Henry-Loi/Embedded-Game-Console/PCB/ELEC3300_V1.1_L4/ELEC3300_V1.1_L4/production/嘉立创SMT订单核对_ELEC3300_V1.1_L4_2023-11-17.pdf

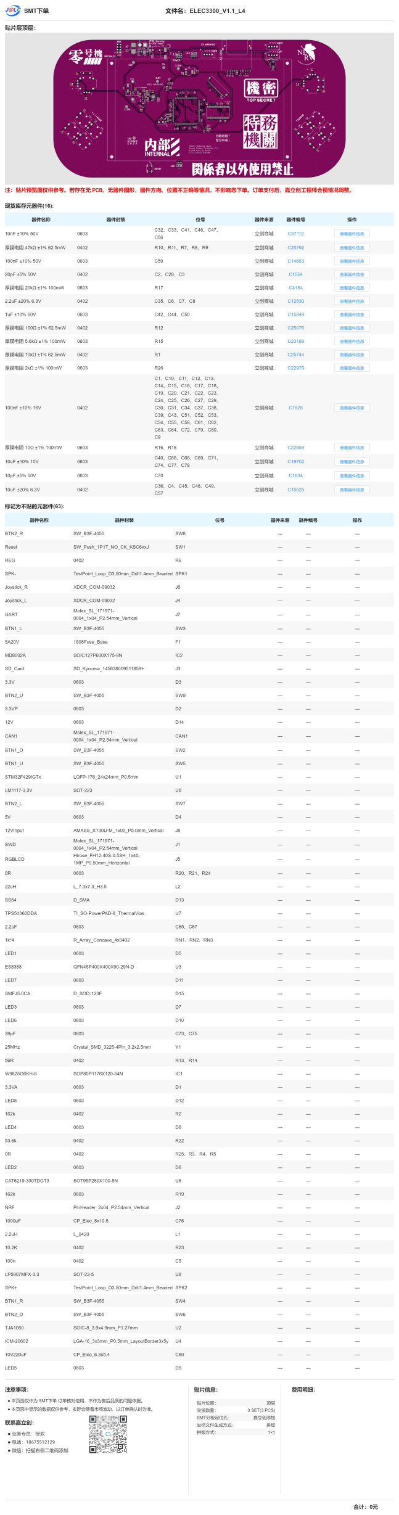
[picture p1: page 1]
