Henry-Loi/Embedded-Game-Console/PCB/screen.DXF

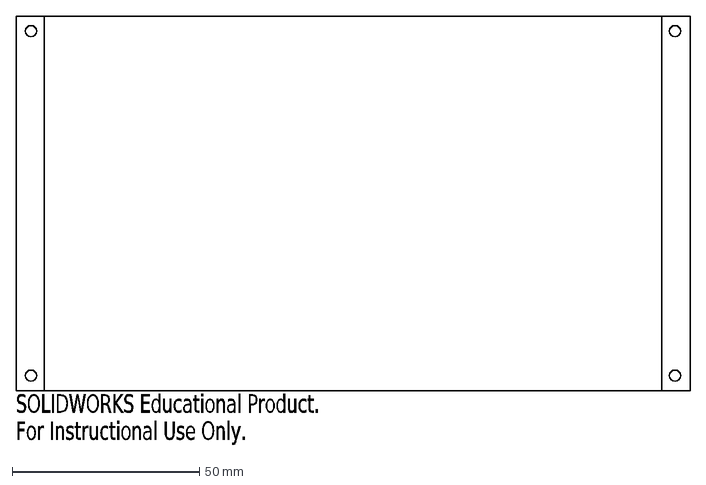
[picture p4: CAD file, 2023-11-17]
PCB/screen.DXF
SOLIDWORKS Educational Product.
For Instructional Use Only.
