Henry-Loi/Embedded-Game-Console/PCB/ELEC3300_V1.1_L4/ELEC3300_V1.1_L4/ELEC3300_V1.1_L4.pdf

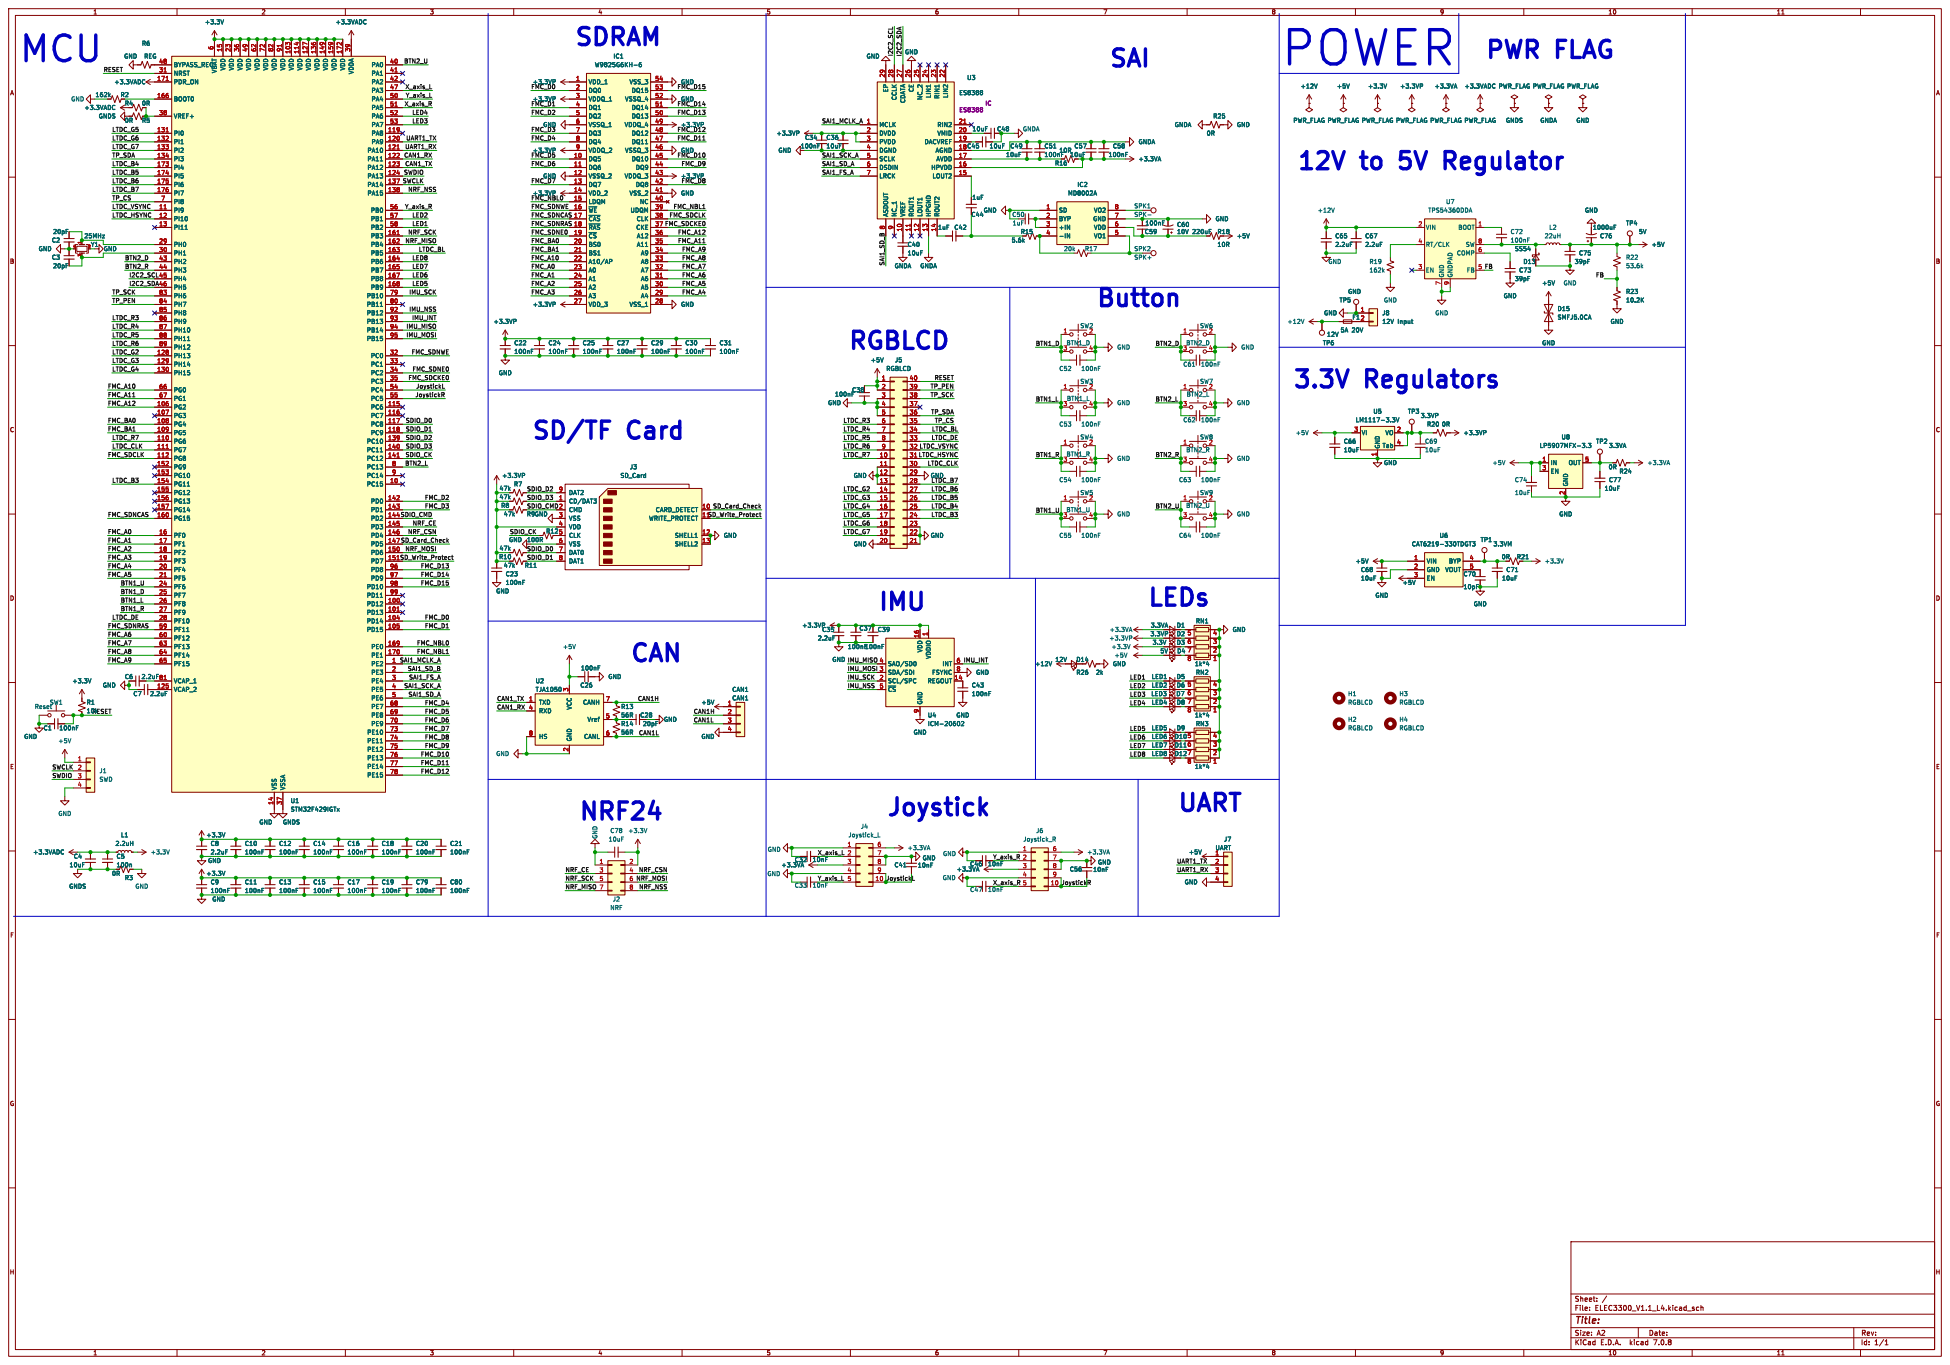
[picture p5: page 1]

1 REGOUT 14 VDD 16 SCL/SPC 2 SDA/SDI 3 SAO/SD0 4 ~{CS} 5

3 RXD 4 Vref 5 CANL 6 CANH 7 HS 8 U2 TJA1050 C19

3 RXD 4 Vref 5 CANL 6 CANH 7 HS 8 C21
