Henry-Loi/Embedded-Game-Console/PCB/ELEC3300_V1.1_L4/ELEC3300_V1.1_L4/ELEC3300_V1.1_L4.kicad_pcb

## KiCad design PCB/ELEC3300_V1.1_L4/ELEC3300_V1.1_L4/ELEC3300_V1.1_L4.kicad_pcb (2023-11-17)

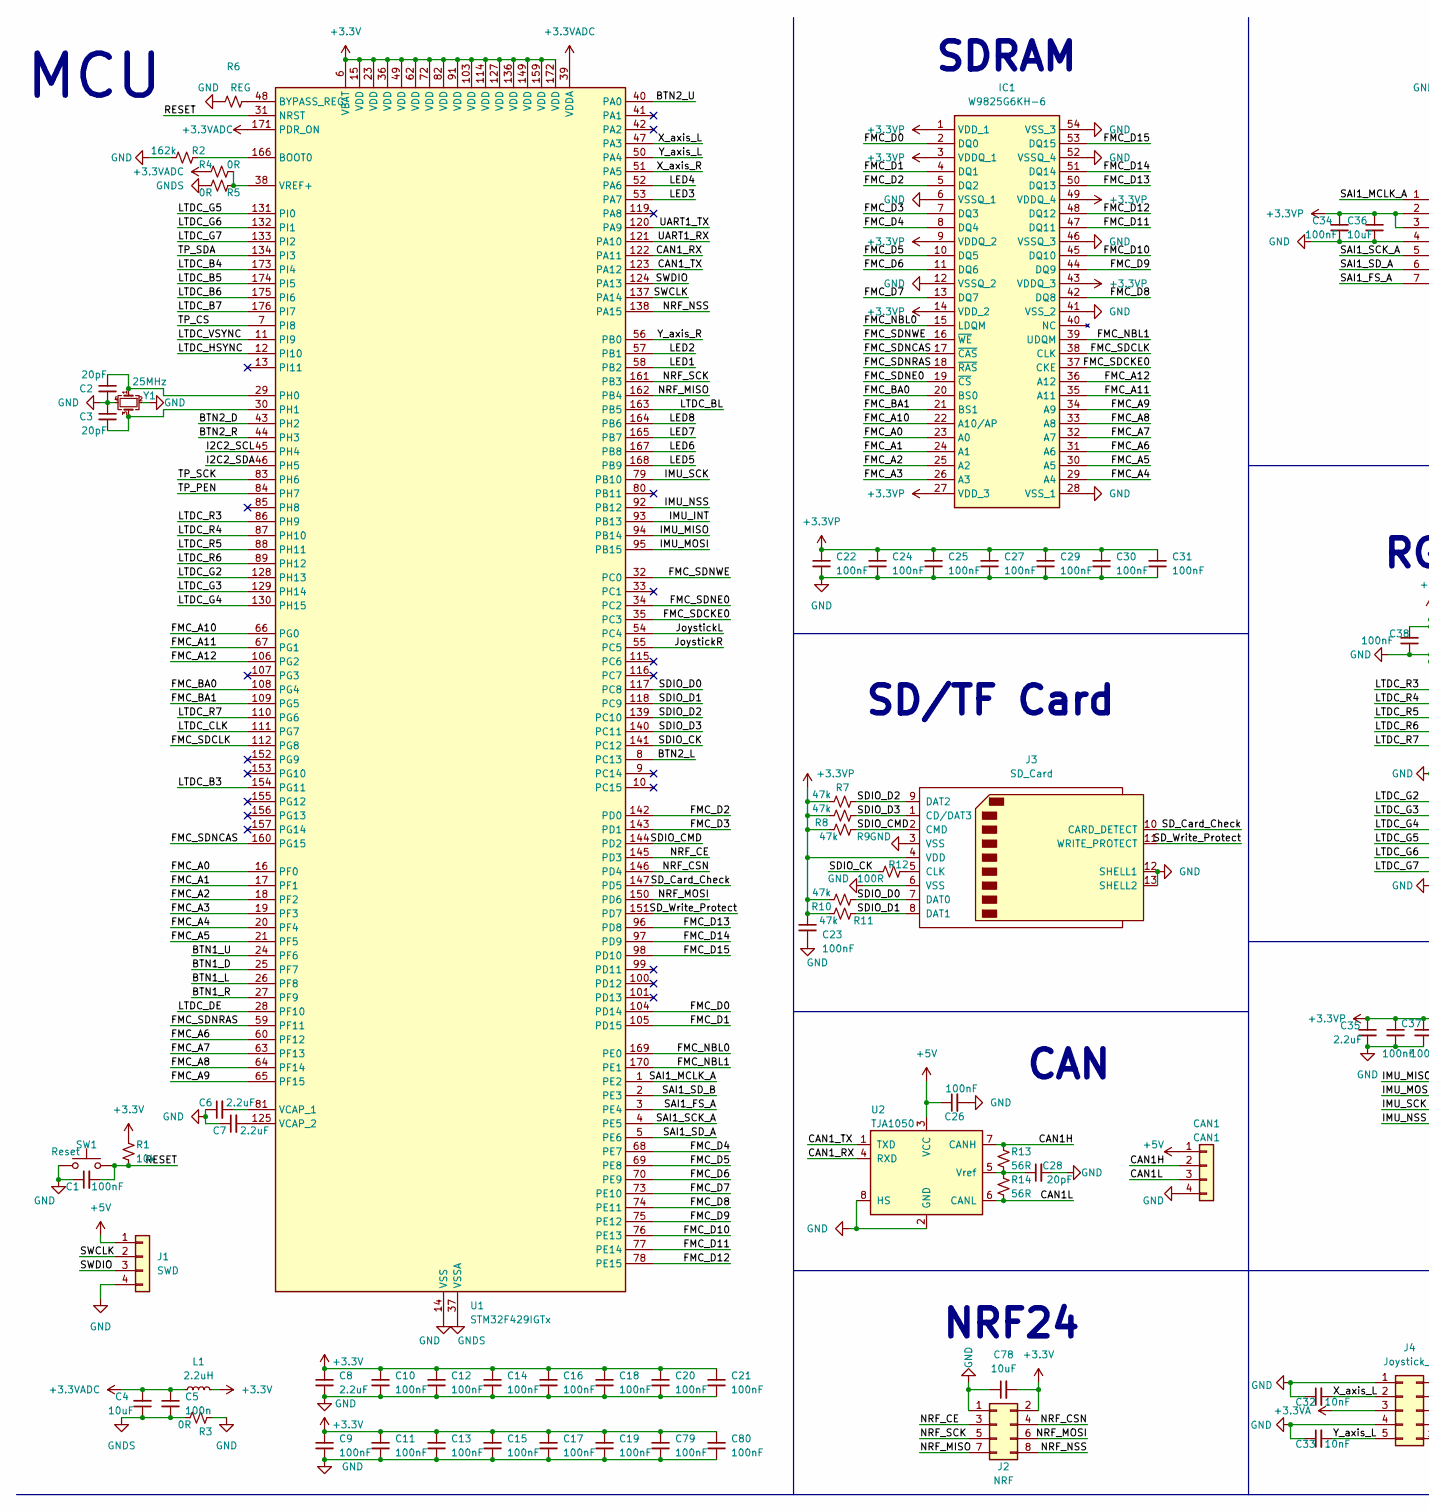
[picture p6: schematic ELEC3300_V1.1_L4.kicad_sch, part in row 1, column 1]

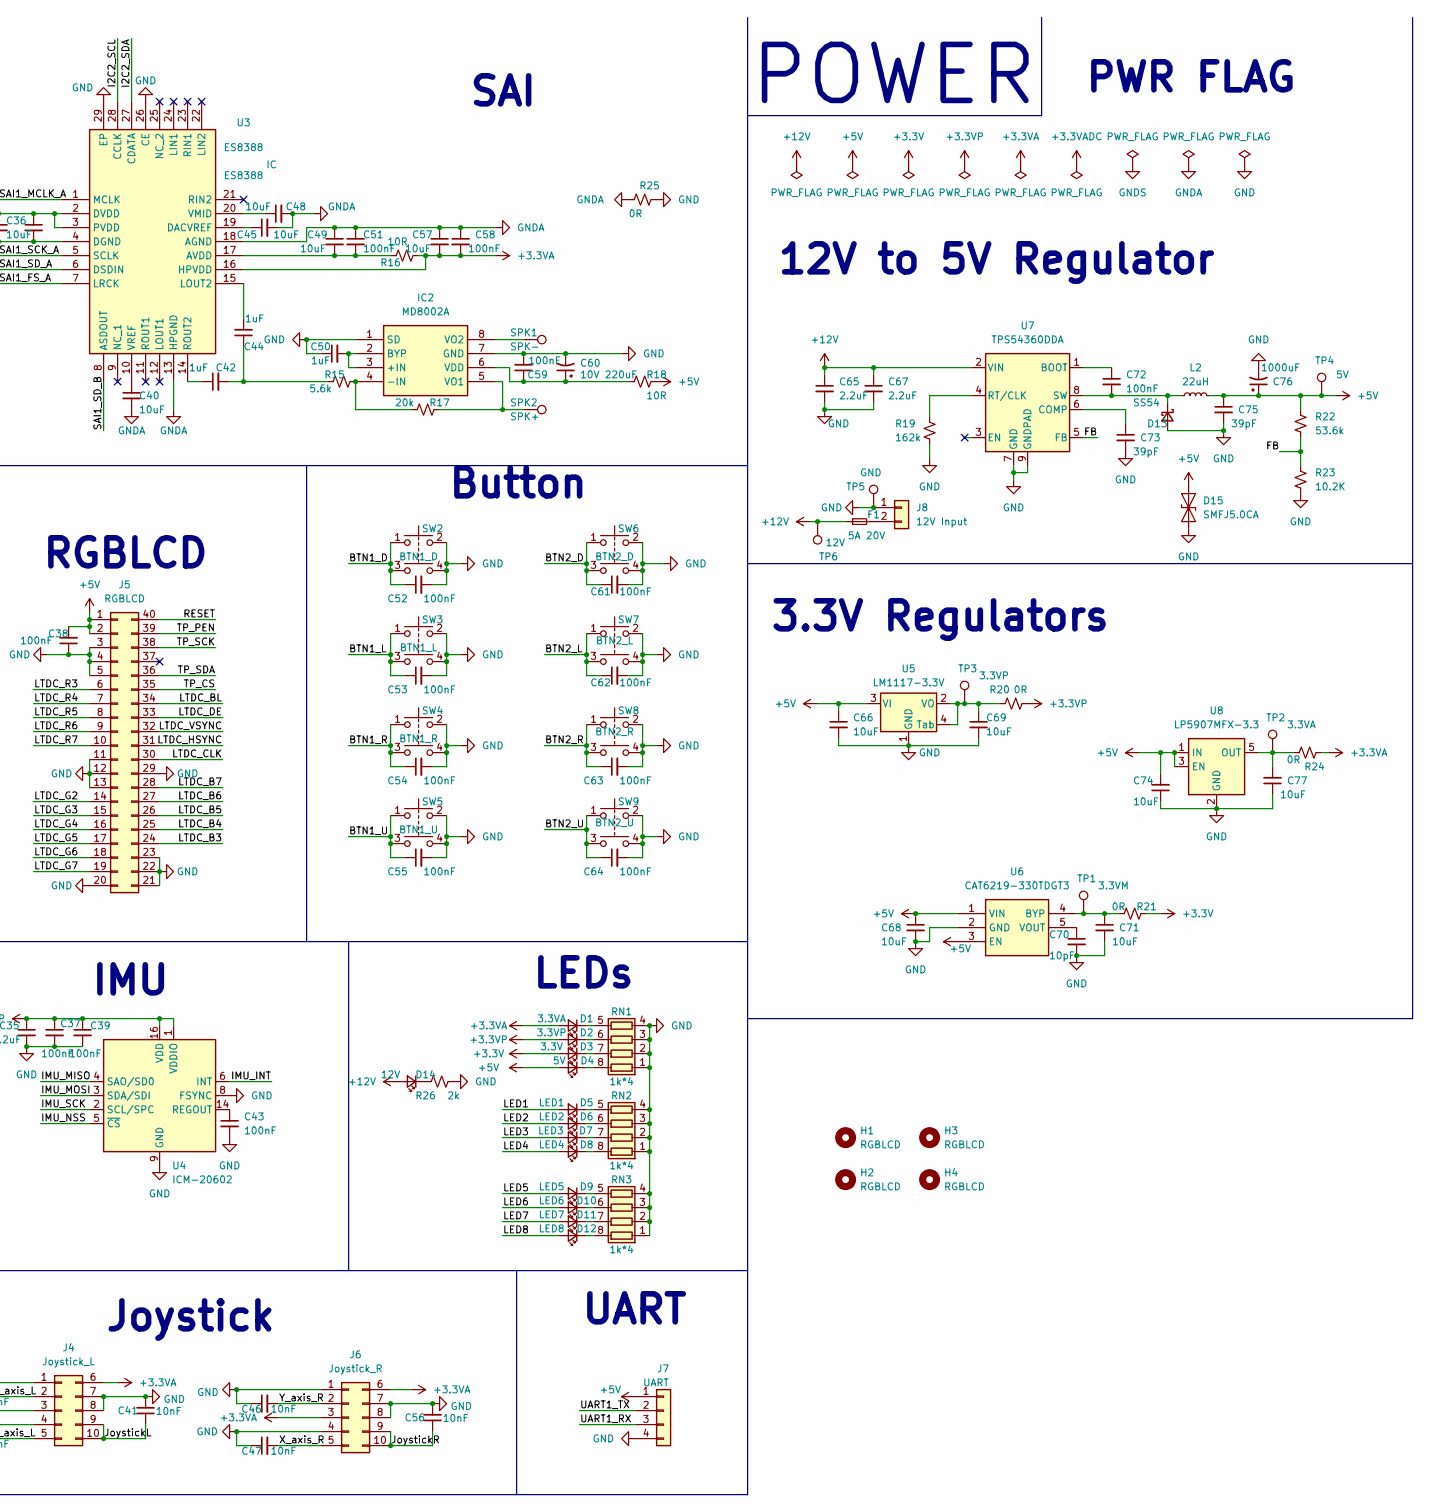
[picture p7: schematic ELEC3300_V1.1_L4.kicad_sch, part in row 1, column 2]

Parts:
C1, C9, C10, C11, C12, C13, C14, C15, C16, C17, C18, C19, C20, C21, C22, C23, C24, C25, C26, C27, C29, C30, C31, C34, C37, C38, C39, C43, C51, C52, C53, C54, C55, C58, C61, C62, C63, C64, C72, C79, C80: 100nF; C_0402_1005Metric_Pad0.74x0.62mm_HandSolder
C2, C3, C28: 20pF; C_0402_1005Metric_Pad0.74x0.62mm_HandSolder
C4, C36, C45, C49, C57: 10uF; C_0402_1005Metric_Pad0.74x0.62mm_HandSolder
C5: 100n; C_0402_1005Metric_Pad0.74x0.62mm_HandSolder
C6, C7, C8, C35: 2.2uF; C_0402_1005Metric_Pad0.74x0.62mm_HandSolder
C32, C33, C41, C46, C47, C56: 10nF; C_0603_1608Metric
C40, C66, C68, C69, C71, C74, C77, C78: 10uF; C_0603_1608Metric
C42, C44, C50: 1uF; C_0603_1608Metric
C48: 10uF; R_0402_1005Metric_Pad0.72x0.64mm_HandSolder
C59: 100nF; C_0603_1608Metric
C60: 10V 220uF; CP_Elec_6.3x5.4
C65, C67: 2.2uF; C_0603_1608Metric
C70: 10pF; C_0603_1608Metric
C73, C75: 39pF; C_0603_1608Metric
C76: 1000uF; CP_Elec_8x10.5
CAN1: CAN1; Molex_SL_171971-0004_1x04_P2.54mm_Vertical
D1: 3.3VA; LED_0603_1608Metric
D2: 3.3VP; LED_0603_1608Metric
D3: 3.3V; LED_0603_1608Metric
D4: 5V; LED_0603_1608Metric
D5: LED1; LED_0603_1608Metric
D6: LED2; LED_0603_1608Metric
D7: LED3; LED_0603_1608Metric
D8: LED4; LED_0603_1608Metric
D9: LED5; LED_0603_1608Metric
D10: LED6; LED_0603_1608Metric
D11: LED7; LED_0603_1608Metric
D12: LED8; LED_0603_1608Metric
D13: SS54; D_SMA
D14: 12V; LED_0603_1608Metric
D15: SMFJ5.0CA; D_SOD-123F
F1: 5A 20V; 1808Fuse_Base
H1, H2, H3, H4: RGBLCD; MountingHole_3.2mm_M3
IC1: W9825G6KH-6; SOP80P1176X120-54N; Manufacturer_Part_Number W9825G6KH-6; Mouser Part Number 454-W9825G6KH-6
IC2: MD8002A; SOIC127P600X175-8N; Manufacturer_Part_Number MD8002A
J1: SWD; Molex_SL_171971-0004_1x04_P2.54mm_Vertical
J2: NRF; PinHeader_2x04_P2.54mm_Vertical
J3: SD_Card; SD_Kyocera_145638009511859+
J4: Joystick_L; XDCR_COM-09032
J5: RGBLCD; Hirose_FH12-40S-0.5SH_1x40-1MP_P0.50mm_Horizontal
J6: Joystick_R; XDCR_COM-09032
J7: UART; Molex_SL_171971-0004_1x04_P2.54mm_Vertical
J8: 12V Input; AMASS_XT30U-M_1x02_P5.0mm_Vertical
L1: 2.2uH; L_0420
L2: 22uH; L_7.3x7.3_H3.5
R1: 10k; R_0402_1005Metric_Pad0.72x0.64mm_HandSolder
R2: 162k; L_0402_1005Metric_Pad0.77x0.64mm_HandSolder
R3, R4, R5, R25: 0R; R_0402_1005Metric_Pad0.72x0.64mm_HandSolder
R6: REG; R_0402_1005Metric_Pad0.72x0.64mm_HandSolder
R7, R8, R9, R10, R11: 47k; R_0402_1005Metric_Pad0.72x0.64mm_HandSolder
R12: 100R; R_0402_1005Metric_Pad0.72x0.64mm_HandSolder
R13, R14: 56R; R_0402_1005Metric_Pad0.72x0.64mm_HandSolder
R15: 5.6k; R_0603_1608Metric
R16, R18: 10R; R_0603_1608Metric
R17: 20k; R_0603_1608Metric
R19: 162k; R_0603_1608Metric
R20, R21, R24: 0R; R_0603_1608Metric_Pad0.98x0.95mm_HandSolder
R22: 53.6k; R_0402_1005Metric_Pad0.72x0.64mm_HandSolder
R23: 10.2K; R_0402_1005Metric_Pad0.72x0.64mm_HandSolder
R26: 2k; R_0603_1608Metric_Pad0.98x0.95mm_HandSolder
RN1, RN2, RN3: 1k*4; R_Array_Concave_4x0402
SPK1: SPK-; TestPoint_Loop_D3.50mm_Drill1.4mm_Beaded
SPK2: SPK+; TestPoint_Loop_D3.50mm_Drill1.4mm_Beaded
SW1: Reset; SW_Push_1P1T_NO_CK_KSC6xxJ
SW2: BTN1_D; SW_B3F-4055
SW3: BTN1_L; SW_B3F-4055
SW4: BTN1_R; SW_B3F-4055
SW5: BTN1_U; SW_B3F-4055
SW6: BTN2_D; SW_B3F-4055
SW7: BTN2_L; SW_B3F-4055
SW8: BTN2_R; SW_B3F-4055
SW9: BTN2_U; SW_B3F-4055
TP1: 3.3VM; TestPoint_Pad_D2.5mm
TP2: 3.3VA; TestPoint_Pad_D2.5mm
TP3: 3.3VP; TestPoint_Pad_D2.5mm
TP4: 5V; TestPoint_Pad_D2.5mm
TP5: GND; TestPoint_Pad_D2.5mm
TP6: 12V; TestPoint_Pad_D2.5mm
U1: STM32F429IGTx; LQFP-176_24x24mm_P0.5mm
U2: TJA1050; SOIC-8_3.9x4.9mm_P1.27mm
U3: ES8388; QFN45P400X400X90-29N-D; Manufacturer_Part_Number ES8388
U4: ICM-20602; LGA-16_3x3mm_P0.5mm_LayoutBorder3x5y
U5: LM1117-3.3V; SOT-223
U6: CAT6219-330TDGT3; SOT95P280X100-5N; Manufacturer_Part_Number CAT6219-330TDGT3; Mouser Part Number 698-CAT6219-330TD-G
U7: TPS54360DDA; TI_SO-PowerPAD-8_ThermalVias
U8: LP5907MFX-3.3; SOT-23-5
Y1: 25MHz; Crystal_SMD_3225-4Pin_3.2x2.5mm

Connections:
+3.3V: C8.1, C9.1, C10.1, C11.1, C12.1, C13.1, C14.1, C15.1, C16.1, C17.1, C18.1, C19.1, C20.1, C21.1, C78.2, C79.1, C80.1, D3.2 (A), J2.2, L1.2, R1.2, R21.2, U1.6 (VBAT), U1.15 (VDD), U1.23 (VDD), U1.36 (VDD), U1.49 (VDD), U1.62 (VDD), U1.72 (VDD), U1.82 (VDD), U1.91 (VDD), U1.103 (VDD), U1.114 (VDD), U1.127 (VDD), U1.136 (VDD), U1.149 (VDD), U1.159 (VDD), U1.172 (VDD)
+3.3VA: C57.2, C58.2, D1.2 (A), J4.3, J4.6, J6.3, J6.6, R16.2, R24.2, U3.16 (HPVDD)
+3.3VADC: C4.2, C5.1, L1.1, R4.1, U1.39 (VDDA), U1.171 (PDR_ON)
+3.3VP: C22.1, C23.1, C24.1, C25.1, C27.1, C29.1, C30.1, C31.1, C34.1, C35.1, C36.1, C37.1, C39.1, D2.2 (A), IC1.1 (VDD_1), IC1.3 (VDDQ_1), IC1.9 (VDDQ_2), IC1.14 (VDD_2), IC1.27 (VDD_3), IC1.43 (VDDQ_3), IC1.49 (VDDQ_4), J3.4 (VDD), R7.1, R8.1, R9.1, R10.1, R11.1, R20.2, U3.2 (DVDD), U3.3 (PVDD), U4.1 (VDDIO), U4.16 (VDD)
+5V: C26.1, C38.2, C66.1, C68.1, C74.2, C75.1, C76.1, CAN1.1, D4.2 (A), D15.1 (A1), J1.1, J5.1, J5.2, J7.1, L2.2, R18.2, R22.1, TP4.1, U2.3 (VCC), U5.3 (VI), U6.1 (VIN), U6.3 (EN), U8.1 (IN), U8.3 (EN)
+12V: C65.1, C67.1, D14.2 (A), F1.1, TP6.1, U7.2 (VIN)
/BTN1_D: C52.1, SW2.1, SW2.3, U1.25 (PF7)
/BTN1_L: C53.1, SW3.1, SW3.3, U1.26 (PF8)
/BTN1_R: C54.1, SW4.1, SW4.3, U1.27 (PF9)
/BTN1_U: C55.1, SW5.1, SW5.3, U1.24 (PF6)
/BTN2_D: C61.1, SW6.1, SW6.3, U1.43 (PH2)
/BTN2_L: C62.1, SW7.1, SW7.3, U1.8 (PC13)
/BTN2_R: C63.1, SW8.1, SW8.3, U1.44 (PH3)
/BTN2_U: C64.1, SW9.1, SW9.3, U1.40 (PA0)
/CAN1H: CAN1.2, R13.1, U2.7 (CANH)
/CAN1L: CAN1.3, R14.2, U2.6 (CANL)
/CAN1_RX: U1.122 (PA11), U2.4 (RXD)
/CAN1_TX: U1.123 (PA12), U2.1 (TXD)
/FB: R22.2, R23.1, U7.5 (FB)
/FMC_A0: IC1.23 (A0), U1.16 (PF0)
/FMC_A1: IC1.24 (A1), U1.17 (PF1)
/FMC_A2: IC1.25 (A2), U1.18 (PF2)
/FMC_A3: IC1.26 (A3), U1.19 (PF3)
/FMC_A4: IC1.29 (A4), U1.20 (PF4)
/FMC_A5: IC1.30 (A5), U1.21 (PF5)
/FMC_A6: IC1.31 (A6), U1.60 (PF12)
/FMC_A7: IC1.32 (A7), U1.63 (PF13)
/FMC_A8: IC1.33 (A8), U1.64 (PF14)
/FMC_A9: IC1.34 (A9), U1.65 (PF15)
/FMC_A10: IC1.22 (A10/AP), U1.66 (PG0)
/FMC_A11: IC1.35 (A11), U1.67 (PG1)
/FMC_A12: IC1.36 (A12), U1.106 (PG2)
/FMC_BA0: IC1.20 (BS0), U1.108 (PG4)
/FMC_BA1: IC1.21 (BS1), U1.109 (PG5)
/FMC_D0: IC1.2 (DQ0), U1.104 (PD14)
/FMC_D1: IC1.4 (DQ1), U1.105 (PD15)
/FMC_D2: IC1.5 (DQ2), U1.142 (PD0)
/FMC_D3: IC1.7 (DQ3), U1.143 (PD1)
/FMC_D4: IC1.8 (DQ4), U1.68 (PE7)
/FMC_D5: IC1.10 (DQ5), U1.69 (PE8)
/FMC_D6: IC1.11 (DQ6), U1.70 (PE9)
/FMC_D7: IC1.13 (DQ7), U1.73 (PE10)
/FMC_D8: IC1.42 (DQ8), U1.74 (PE11)
/FMC_D9: IC1.44 (DQ9), U1.75 (PE12)
/FMC_D10: IC1.45 (DQ10), U1.76 (PE13)
/FMC_D11: IC1.47 (DQ11), U1.77 (PE14)
/FMC_D12: IC1.48 (DQ12), U1.78 (PE15)
/FMC_D13: IC1.50 (DQ13), U1.96 (PD8)
/FMC_D14: IC1.51 (DQ14), U1.97 (PD9)
/FMC_D15: IC1.53 (DQ15), U1.98 (PD10)
/FMC_NBL0: IC1.15 (LDQM), U1.169 (PE0)
/FMC_NBL1: IC1.39 (UDQM), U1.170 (PE1)
/FMC_SDCKE0: IC1.37 (CKE), U1.35 (PC3)
/FMC_SDCLK: IC1.38 (CLK), U1.112 (PG8)
/FMC_SDNCAS: IC1.17 (~CAS), U1.160 (PG15)
/FMC_SDNE0: IC1.19 (~CS), U1.34 (PC2)
/FMC_SDNRAS: IC1.18 (~RAS), U1.59 (PF11)
/FMC_SDNWE: IC1.16 (~WE), U1.32 (PC0)
/I2C2_SCL: U1.45 (PH4), U3.28 (CCLK)
/I2C2_SDA: U1.46 (PH5), U3.27 (CDATA)
/IMU_INT: U1.93 (PB13), U4.6 (INT)
/IMU_MISO: U1.94 (PB14), U4.4 (SAO/SD0)
/IMU_MOSI: U1.95 (PB15), U4.3 (SDA/SDI)
/IMU_NSS: U1.92 (PB12), U4.5 (~CS)
/IMU_SCK: U1.79 (PB10), U4.2 (SCL/SPC)
/JoystickL: C41.1, J4.9, J4.10, U1.54 (PC4)
/JoystickR: C56.1, J6.9, J6.10, U1.55 (PC5)
/LED1: D5.2 (A), U1.58 (PB2)
/LED2: D6.2 (A), U1.57 (PB1)
/LED3: D7.2 (A), U1.53 (PA7)
/LED4: D8.2 (A), U1.52 (PA6)
/LED5: D9.2 (A), U1.168 (PB9)
/LED6: D10.2 (A), U1.167 (PB8)
/LED7: D11.2 (A), U1.165 (PB7)
/LED8: D12.2 (A), U1.164 (PB6)
/LTDC_B3: J5.24, U1.154 (PG11)
/LTDC_B4: J5.25, U1.173 (PI4)
/LTDC_B5: J5.26, U1.174 (PI5)
/LTDC_B6: J5.27, U1.175 (PI6)
/LTDC_B7: J5.28, U1.176 (PI7)
/LTDC_BL: J5.34, U1.163 (PB5)
/LTDC_CLK: J5.30, U1.111 (PG7)
/LTDC_DE: J5.33, U1.28 (PF10)
/LTDC_G2: J5.14, U1.128 (PH13)
/LTDC_G3: J5.15, U1.129 (PH14)
/LTDC_G4: J5.16, U1.130 (PH15)
/LTDC_G5: J5.17, U1.131 (PI0)
/LTDC_G6: J5.18, U1.132 (PI1)
/LTDC_G7: J5.19, U1.133 (PI2)
/LTDC_HSYNC: J5.31, U1.12 (PI10)
/LTDC_R3: J5.6, U1.86 (PH9)
/LTDC_R4: J5.7, U1.87 (PH10)
/LTDC_R5: J5.8, U1.88 (PH11)
/LTDC_R6: J5.9, U1.89 (PH12)
/LTDC_R7: J5.10, U1.110 (PG6)
/LTDC_VSYNC: J5.32, U1.11 (PI9)
/NRF_CE: J2.3, U1.145 (PD3)
/NRF_CSN: J2.4, U1.146 (PD4)
/NRF_MISO: J2.7, U1.162 (PB4)
/NRF_MOSI: J2.6, U1.150 (PD6)
/NRF_NSS: J2.8, U1.138 (PA15)
/NRF_SCK: J2.5, U1.161 (PB3)
/RESET: C1.2, J5.40, R1.1, SW1.2, U1.31 (NRST)
/SAI1_FS_A: U1.3 (PE4), U3.7 (LRCK)
/SAI1_MCLK_A: U1.1 (PE2), U3.1 (MCLK)
/SAI1_SCK_A: U1.4 (PE5), U3.5 (SCLK)
/SAI1_SD_A: U1.5 (PE6), U3.6 (DSDIN)
/SAI1_SD_B: U1.2 (PE3), U3.8 (ASDOUT)
/SDIO_CK: R12.1, U1.141 (PC12)
/SDIO_CMD: J3.2 (CMD), R9.2, U1.144 (PD2)
/SDIO_D0: J3.7 (DAT0), R10.2, U1.117 (PC8)
/SDIO_D1: J3.8 (DAT1), R11.2, U1.118 (PC9)
/SDIO_D2: J3.9 (DAT2), R7.2, U1.139 (PC10)
/SDIO_D3: J3.1 (CD/DAT3), R8.2, U1.140 (PC11)
/SD_Card_Check: J3.10 (CARD_DETECT), U1.147 (PD5)
/SD_Write_Protect: J3.11 (WRITE_PROTECT), U1.151 (PD7)
/SWCLK: J1.2, U1.137 (PA14)
/SWDIO: J1.3, U1.124 (PA13)
/TP_CS: J5.35, U1.7 (PI8)
/TP_PEN: J5.39, U1.84 (PH7)
/TP_SCK: J5.38, U1.83 (PH6)
/TP_SDA: J5.36, U1.134 (PI3)
/UART1_RX: J7.3, U1.121 (PA10)
/UART1_TX: J7.2, U1.120 (PA9)
/X_axis_L: C32.2, J4.2, U1.47 (PA3)
/X_axis_R: C47.2, J6.5, U1.51 (PA5)
/Y_axis_L: C33.2, J4.5, U1.50 (PA4)
/Y_axis_R: C46.2, J6.2, U1.56 (PB0)
GND: C1.1, C2.2, C3.1, C6.1, C7.1, C8.2, C9.2, C10.2, C11.2, C12.2, C13.2, C14.2, C15.2, C16.2, C17.2, C18.2, C19.2, C20.2, C21.2, C22.2, C23.2, C24.2, C25.2, C26.2, C27.2, C28.2, C29.2, C30.2, C31.2, C32.1, C33.1, C34.2, C35.2, C36.2, C37.2, C38.1, C39.2, C41.2, C43.2, C46.1, C47.1, C50.1, C52.2, C53.2, C54.2, C55.2, C56.2, C59.2, C60.2, C61.2, C62.2, C63.2, C64.2, C65.2, C66.2, C67.2, C68.2, C69.2, C70.2, C71.2, C73.2, C74.1, C75.2, C76.2, C77.1, C78.1, C79.2, C80.2, CAN1.4, D13.2 (A), D15.2 (A2), IC1.6 (VSSQ_1), IC1.12 (VSSQ_2), IC1.28 (VSS_1), IC1.41 (VSS_2), IC1.46 (VSSQ_3), IC1.52 (VSSQ_4), IC1.54 (VSS_3), IC2.1 (SD), IC2.7 (GND), J1.4, J2.1, J3.3 (VSS), J3.6 (VSS), J3.12 (SHELL1), J3.13 (SHELL2), J4.1, J4.4, J4.7, J4.8, J5.3, J5.4, J5.5, J5.11, J5.12, J5.13, J5.20, J5.21, J5.22, J5.23, J5.29, J6.1, J6.4, J6.7, J6.8, J7.4, J8.1, R2.1, R3.2, R6.1, R19.2, R23.2, R25.2, R26.2, RN1.1 (R1.1), RN1.2 (R2.1), RN1.3 (R3.1), RN1.4 (R4.1), RN2.1 (R1.1), RN2.2 (R2.1), RN2.3 (R3.1), RN2.4 (R4.1), RN3.1 (R1.1), RN3.2 (R2.1), RN3.3 (R3.1), RN3.4 (R4.1), SW1.1, SW2.2, SW2.4, SW3.2, SW3.4, SW4.2, SW4.4, SW5.2, SW5.4, SW6.2, SW6.4, SW7.2, SW7.4, SW8.2, SW8.4, SW9.2, SW9.4, TP5.1, U1.14 (VSS), U1.22 (VSS), U1.61 (VSS), U1.71 (VSS), U1.90 (VSS), U1.102 (VSS), U1.113 (VSS), U1.126 (VSS), U1.135 (VSS), U1.148 (VSS), U1.158 (VSS), U2.2 (GND), U2.8 (HS), U3.4 (DGND), U3.26 (CE), U3.29 (EP), U4.8 (FSYNC), U4.9 (GND), U4.10 (GND), U4.11 (GND), U4.12 (GND), U4.13 (GND), U4.15 (GND), U5.1 (GND), U6.2 (GND), U7.7 (GND), U7.9 (GNDPAD), U8.2 (GND), Y1.2, Y1.4
GNDA: C40.2, C45.2, C48.2, C49.1, C51.1, C57.1, C58.1, R25.1, U3.13 (HPGND), U3.18 (AGND)
GNDS: C4.1, C5.2, R3.1, R5.1, U1.37 (VSSA)
unnamed: C42.2, C44.1, R15.1
unnamed: D1.1 (K), RN1.5 (R4.2)
unnamed: D2.1 (K), RN1.6 (R3.2)
unnamed: D3.1 (K), RN1.7 (R2.2)
unnamed: D4.1 (K), RN1.8 (R1.2)
unnamed: D5.1 (K), RN2.5 (R4.2)
unnamed: D6.1 (K), RN2.6 (R3.2)
unnamed: D7.1 (K), RN2.7 (R2.2)
unnamed: D8.1 (K), RN2.8 (R1.2)
unnamed: D9.1 (K), RN3.5 (R4.2)
unnamed: D10.1 (K), RN3.6 (R3.2)
unnamed: D11.1 (K), RN3.7 (R2.2)
unnamed: D12.1 (K), RN3.8 (R1.2)
unnamed: C72.2, D13.1 (K), L2.1, U7.8 (SW)
unnamed: D14.1 (K), R26.1
unnamed: C50.2, IC2.2 (BYP), IC2.3 (+IN)
unnamed: IC2.4 (-IN), R15.2, R17.1
unnamed: C59.1, C60.1, IC2.6 (VDD), R18.1
unnamed: IC2.5 (VO1), R17.2, SPK2.1
unnamed: IC2.8 (VO2), SPK1.1
unnamed: J3.5 (CLK), R12.2
unnamed: F1.2, J8.2
unnamed: R2.2, U1.166 (BOOT0)
unnamed: R6.2, U1.48 (BYPASS_REG)
unnamed: C2.1, U1.29 (PH0), Y1.1
unnamed: C3.2, U1.30 (PH1), Y1.3
unnamed: C6.2, U1.81 (VCAP_1)
unnamed: C7.2, U1.125 (VCAP_2)
unnamed: R4.2, R5.2, U1.38 (VREF+)
unnamed: C28.1, R13.2, R14.1, U2.5 (Vref)
unnamed: C49.2, C51.2, R16.1, U3.17 (AVDD)
unnamed: C45.1, U3.19 (DACVREF)
unnamed: C44.2, U3.15 (LOUT2)
unnamed: C42.1, U3.14 (ROUT2)
unnamed: C48.1, U3.20 (VMID)
unnamed: C40.1, U3.10 (VREF)
unnamed: C43.1, U4.14 (REGOUT)
unnamed: C69.1, R20.1, TP3.1, U5.2 (VO), U5.4 (Tab)
unnamed: C71.1, R21.1, TP1.1, U6.4 (BYP)
unnamed: C70.1, U6.5 (VOUT)
unnamed: C72.1, U7.1 (BOOT)
unnamed: C73.1, U7.6 (COMP)
unnamed: R19.1, U7.4 (RT/CLK)
unnamed: C77.2, R24.1, TP2.1, U8.5 (OUT)

Notes on the sheet:
3.3V Regulators
MCU
POWER
IMU
LEDs
Joystick
SAI
UART
PWR FLAG
12V to 5V Regulator
CAN
Button
RGBLCD
SD/TF Card
NRF24
SDRAM

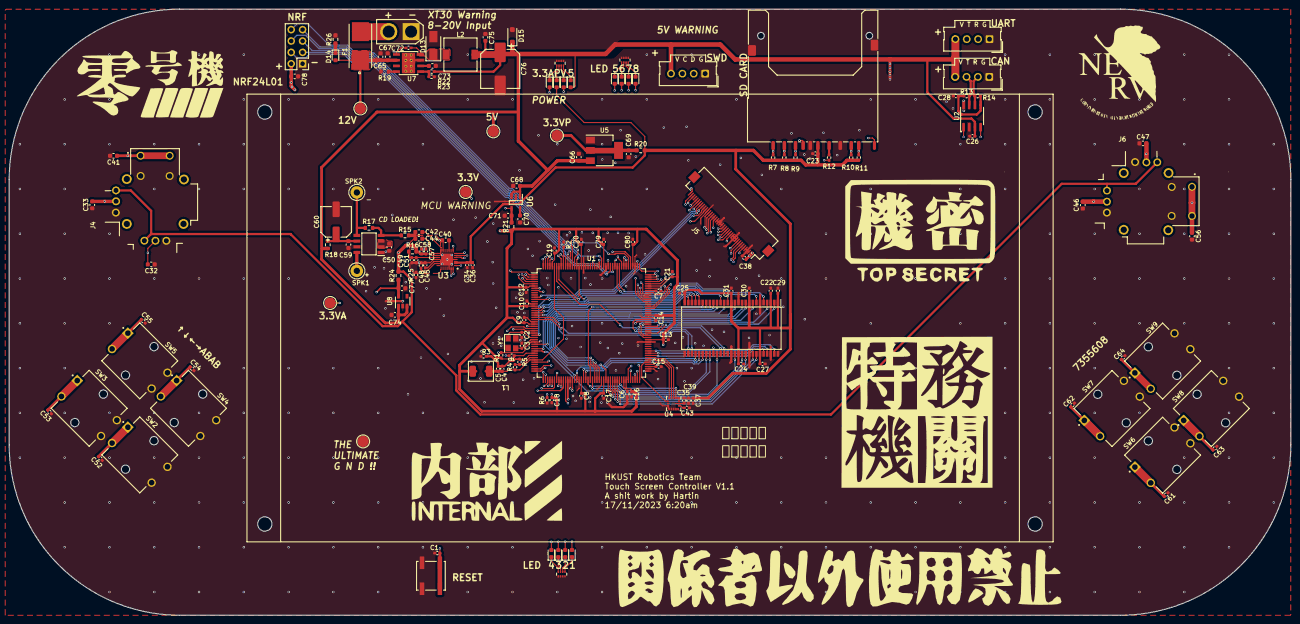
[picture p8: board ELEC3300_V1.1_L4.kicad_pcb from above]

Board: 4 copper layers, 286.2 x 135.3 mm, 168 parts (0 on the bottom side), 175 nets.
