Henry-Loi/Embedded-Game-Console/_My_RGB/Src/main.c

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

/* Includes ------------------------------------------------------------------*/
#include "main.h"
#include "dma.h"
#include "dma2d.h"
#include "fatfs.h"
#include "ltdc.h"
#include "sdio.h"
#include "usart.h"
#include "gpio.h"
#include "fmc.h"

/* USER CODE BEGIN Includes */

#include "BSP_RGB_LCD.h"
#include "image.h"
#include "GUI_Paint.h"
#include "GT911.h"
#include "malloc.h"	  
#include "usmart.h"
#include "ff.h"
#include "ff_gen_drv.h"	
#include "piclib.h"

/* USER CODE END Includes */

/* USER CODE BEGIN PTD */
extern GT911_Dev Dev_Now;

void HAL_GPIO_EXTI_Callback(uint16_t GPIO_Pin)
{
	if(GPIO_Pin == GPIO_PIN_7)
	{
		Dev_Now.Touch = 1;
	}
}
/* USER CODE END PTD */


void SystemClock_Config(void);
/* USER CODE BEGIN 0 */

//FATFS SDFatFs;  /* File system object for SD card logical drive */
//FIL MyFile;     /* File object */
//char SDPath[4]; /* SD card logical drive path */
//static uint8_t buffer[_MAX_SS]; /* a work buffer for the f_mkfs() */

uint16_t *picture = NULL;

/* USER CODE END 0 */

/**
  * @brief  The application entry point.
  * @retval int
  */
int main(void)
{
  /* USER CODE BEGIN 1 */
	
//  FRESULT res;                                          /* FatFs function common result code */
//  uint32_t byteswritten, bytesread;                     /* File write/read counts */
//  uint8_t wtext[] = "This is STM32 working with FatFs"; /* File write buffer */
//  uint8_t rtext[100];                                   /* File read buffer */
//	uint8_t buffer[512];
	
	
  /* USER CODE END 1 */
  

  /* MCU Configuration--------------------------------------------------------*/

  /* Reset of all peripherals, Initializes the Flash interface and the Systick. */
  HAL_Init();

  /* Configure the system clock */
  SystemClock_Config();

  /* Initialize all configured peripherals */
  MX_GPIO_Init();
  MX_LTDC_Init();
  MX_FMC_Init();
  MX_DMA2D_Init();
  MX_USART1_UART_Init();
  MX_DMA_Init();
  MX_SDIO_SD_Init();
//  MX_FATFS_Init();
  /* USER CODE BEGIN 2 */
	
	/*LCD初始化*/
	BSP_LCD_Init();
	
	/*打开背光*/
	HAL_GPIO_WritePin(GPIOB,GPIO_PIN_5,GPIO_PIN_SET);
	
/*malloc.c中初始化内存池*/
	my_mem_init(SRAMIN);		    //初始化内部内存池
	my_mem_init(SRAMEX);		    //初始化外部内存池
	my_mem_init(SRAMCCM);		    //初始化CCM内存池 
	
/*USMART调试工具初始化*/
	usmart_dev.init(90);
	

	/*使能串口1接受中断*/
	__HAL_UART_ENABLE_IT(&huart1,UART_IT_RXNE); 
	
	/*为fatfs相关变量申请内存	*/
	exfuns_init();
	
	/*FATFS文件系统初始化，初始化SD卡并挂载SD卡*/
	if(FATFS_LinkDriver(&SD_Driver, SDPath) == 0)
		{
			/*##-2- Register the file system object to the FatFs module ##############*/
			if(f_mount(&SDFatFS, (TCHAR const*)SDPath, 0) != FR_OK)
			{
				/* FatFs Initialization Error */
				Error_Handler();
				Debug("挂载失败\r\n");
			}
			else
			{
				/*##-3- Create a FAT file system (format) on the logical drive #########*/
				/* WARNING: Formatting the uSD card will delete all content on the device */
				if(disk_initialize(0) != 0)//在这一步进行了SD卡初始化   f_mkfs((TCHAR const*)SDPath, FM_ANY, 0, buffer, sizeof(buffer)) != FR_OK  disk_initialize(0) != 0
				{
					/* FatFs Format Error */
					Error_Handler();
					Debug("SD卡初始化失败\r\n");
				}
				else
				{       
					/*##-4- Create and Open a new text file object with write access #####*/
//					if(f_open(&SDFile, "STM32.TXT", FA_CREATE_ALWAYS | FA_WRITE) != FR_OK)
//					{
//						/* 'STM32.TXT' file Open for write Error */
//						Error_Handler();
//						Debug("创建文件失败\r\n");
//					}
//					else
//					{
//						/*##-5- Write data to the text file ################################*/
//						res = f_write(&SDFile, wtext, sizeof(wtext), (void *)&byteswritten);

//						/*##-6- Close the open text file #################################*/
//						if (f_close(&SDFile) != FR_OK )
//						{
//							Error_Handler();
//							Debug("关闭文件失败\r\n");
//						}
//						
//						if((byteswritten == 0) || (res != FR_OK))
//						{
//							/* 'STM32.TXT' file Write or EOF Error */
//							Error_Handler();
//							Debug("写文件信息失败\r\n");
//						}
//						else
//						{      
//							/*##-7- Open the text file object with read access ###############*/
//							if(f_open(&SDFile, "STM32.TXT", FA_READ) != FR_OK)
//							{
//								/* 'STM32.TXT' file Open for read Error */
//								Error_Handler();
//								Debug("文件打开失败\r\n");
//							}
//							else
//							{
//								/*##-8- Read data from the text file ###########################*/
//								res = f_read(&SDFile, rtext, sizeof(rtext), (UINT*)&bytesread);
//								
//								if((bytesread == 0) || (res != FR_OK))
//								{
//									/* 'STM32.TXT' file Read or EOF Error */
//									Error_Handler();
//									Debug("文件读取失败或EOF错误\r\n");
//								}
//								else
//								{
//									/*##-9- Close the open text file #############################*/
//									f_close(&SDFile);
//									
//									/*##-10- Compare read data with the expected data ############*/
//									if((bytesread != byteswritten))
//									{                
//										/* Read data is different from the expected data */
//										Error_Handler();
//										Debug("读数据不同\r\n");
//									}
//									else
//									{
										/* Success of the demo: no error occurrence */
										Debug("SD卡挂载并写入成功\r\n");
//									}
//								}
//							}
//						}
//					}
				}
			}
		}
		else
		{
			/* Read data is different from the expected data */
			Error_Handler();
			Debug("FATFS文件系统链接失败r\n");		
		}
		
		
	/*刷屏代码*/
	Paint_NewImage(LCD_WIDTH, LCD_HEIGHT, ROTATE_0, WHITE);
	Paint_Clear(WHITE);
	Paint_DrawString_EN(10, 230, "1234567890", &Font24, 0x000f, 0xfff0);
	Paint_DrawString_EN(10, 260, "ABCDEFGHIJ", &Font24, BLUE, CYAN);
	Paint_DrawString_CN(10, 290, "微雪电子", &Font24CN, BLUE, CYAN);

	Paint_DrawRectangle(200, 230, 300, 330, RED,DRAW_FILL_EMPTY, DOT_PIXEL_2X2 );
	Paint_DrawLine(200, 230, 300, 330, MAGENTA, LINE_STYLE_SOLID, DOT_PIXEL_2X2);
	Paint_DrawLine(300, 230, 200, 330, MAGENTA, LINE_STYLE_SOLID, DOT_PIXEL_2X2);
	Paint_DrawCircle(250, 280, 45, GREEN, DRAW_FILL_EMPTY, DOT_PIXEL_2X2);
	Paint_DrawImage(gImage_800X221, 0, 0, 800, 221);
	Paint_DrawString_EN(715, 0, "clear", &Font24, BLUE, CYAN);/*每个字符占17个x坐标 24个Y坐标*/
	
	/*GT9147触摸IC初始化*/
	GT911_Init();
		
	/*解码图片*/	
//	if(f_open(&SDFile, "image.jpg", FA_READ) == FR_OK)
//	{
//		/* Decode the jpg image file */
//		Debug("文件打开成功\r\n");
//		jpeg_decode(&SDFile, 800, _aucLine, Jpeg_CallbackFunction);
		picture = (uint16_t*)mymalloc(SRAMEX,800*480*2);
		piclib_init();										//初始化画图	
		ai_load_picfile((const u8*)"0:/image2.jpg",0,0,800,480,1);//显示图片   
		
//		Paint_DrawImage((const unsigned char*)picture, 0, 0, 800, 480);
		
		myfree(SRAMEX,picture);
		/* Close the JPG image */
//		f_close(&SDFile);
//	}	
//	else
//	{
//		Debug("文件打开失败\r\n");
//	}
  /* USER CODE END 2 */

  /* Infinite loop */
  /* USER CODE BEGIN WHILE */
  while (1)
  {

        		
		ctp_test();
    /* USER CODE END WHILE */

    /* USER CODE BEGIN 3 */
  }
  /* USER CODE END 3 */
}

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
