Henry-Loi/Embedded-Game-Console/ELEC3300/ELEC3300.ioc

Mcu.UserName=STM32F429IGTx
PA0/WKUP.GPIO_Label=BTN2_U
PA0/WKUP.Signal=GPIO_Input
PA13.Signal=SYS_JTMS-SWDIO
PA14.Signal=SYS_JTCK-SWCLK
PA15.GPIO_Label=NRF_NSS
PA15.Signal=SPI3_NSS
PA3.GPIO_Label=X_axis_L
PA3.Signal=ADCx_IN3
PA4.GPIO_Label=Y_axis_L
PA4.Signal=ADCx_IN4
PA5.GPIO_Label=X_axis_R
PA5.Signal=ADCx_IN5
PA6.GPIO_Label=LED4
PA6.Signal=GPIO_Output
PA7.GPIO_Label=LED3
PA7.Signal=GPIO_Output
PB0.GPIO_Label=Y_axis_R
PB0.Signal=ADCx_IN8
PB1.GPIO_Label=LED1
PB1.Signal=GPIO_Output
PB10.GPIO_Label=IMU_SCK
PB10.Signal=SPI2_SCK
PB12.GPIO_Label=IMU_NSS
PB12.Signal=SPI2_NSS
PB13.GPIO_Label=IMU_INT
PB13.Signal=GPXTI13
PB14.GPIO_Label=IMU_MISO
PB14.Signal=SPI2_MISO
PB15.GPIO_Label=IMU_MOSI
PB15.Signal=SPI2_MOSI
PB2/BOOT1.GPIO_Label=LED2
PB2/BOOT1.Signal=GPIO_Output
PB3.GPIO_Label=NRF_SCK
PB3.Signal=SPI3_SCK
PB4.GPIO_Label=NRF_MISO
PB4.Signal=SPI3_MISO
PB5.GPIO_Label=LCD_BL
PB5.Signal=GPIO_Output
PB6.GPIO_Label=LED8
PB6.Signal=GPIO_Output
PB7.GPIO_Label=LED7
PB7.Signal=GPIO_Output
PB8.GPIO_Label=LED6
PB8.Signal=GPIO_Output
PB9.GPIO_Label=LED5
PB9.Signal=GPIO_Output
PC0.Signal=FMC_SDNWE
PC10.Signal=SDIO_D2
PC11.Signal=SDIO_D3
PC12.Signal=SDIO_CK
PC13.GPIO_Label=BTN2_L
PC13.Signal=GPIO_Input
PC14/OSC32_IN.Signal=RCC_OSC32_IN
PC15/OSC32_OUT.Signal=RCC_OSC32_OUT
PC2.Signal=FMC_SDNE0
PC3.Signal=FMC_SDCKE0
PC4.GPIO_Label=JoystickL
PC4.Signal=GPIO_Input
PC5.GPIO_Label=JoystickR
PC5.Signal=GPIO_Input
PC8.Signal=SDIO_D0
PC9.Signal=SDIO_D1
PD0.Signal=FMC_D2_DA2
PD1.Signal=FMC_D3_DA3
PD10.Signal=FMC_D15_DA15
PD14.Signal=FMC_D0_DA0
PD15.Signal=FMC_D1_DA1
PD2.Signal=SDIO_CMD
PD3.GPIO_Label=NRF_CE
PD3.Signal=GPIO_Output
PD4.GPIO_Label=NRF_CSN
PD4.Signal=GPIO_Output
PD5.GPIO_Label=SD_Card_Check
PD5.Signal=GPIO_Input
PD6.GPIO_Label=NRF_MOSI
PD6.Signal=SPI3_MOSI
PD7.GPIO_Label=SD_Write_Protection
PD7.Signal=GPIO_Output
PD8.Signal=FMC_D13_DA13
PD9.Signal=FMC_D14_DA14
PE0.Signal=FMC_NBL0
PE1.Signal=FMC_NBL1
PE10.Signal=FMC_D7_DA7
PE11.Signal=FMC_D8_DA8
PE12.Signal=FMC_D9_DA9
PE13.Signal=FMC_D10_DA10
PE14.Signal=FMC_D11_DA11
PE15.Signal=FMC_D12_DA12
PE4.GPIO_Label=Joy_R_Btn
PE4.Signal=GPIO_Input
PE6.GPIO_Label=Joy_L_Btn
PE6.Signal=GPIO_Input
PE7.Signal=FMC_D4_DA4
PE8.Signal=FMC_D5_DA5
PE9.Signal=FMC_D6_DA6
PF0.Signal=FMC_A0
PF1.Signal=FMC_A1
PF10.Signal=LTDC_DE
PF11.Signal=FMC_SDNRAS
PF12.Signal=FMC_A6
PF13.Signal=FMC_A7
PF14.Signal=FMC_A8
PF15.Signal=FMC_A9
PF2.Signal=FMC_A2
PF3.Signal=FMC_A3
PF4.Signal=FMC_A4
PF5.Signal=FMC_A5
PF6.GPIO_Label=BTN1_U
PF6.Signal=GPIO_Input
PF7.GPIO_Label=BTN1_D
PF7.Signal=GPIO_Input
PF8.GPIO_Label=BTN1_L
PF8.Signal=GPIO_Input
PF9.GPIO_Label=BTN1_R
PF9.Signal=GPIO_Input
PG0.Signal=FMC_A10
PG1.Signal=FMC_A11
PG11.Signal=LTDC_B3
PG15.Signal=FMC_SDNCAS
PG2.Signal=FMC_A12
PG4.Signal=FMC_A14_BA0
PG5.Signal=FMC_A15_BA1
PG6.Signal=LTDC_R7
PG7.Signal=LTDC_CLK
PG8.Signal=FMC_SDCLK
PH0/OSC_IN.Signal=RCC_OSC_IN
PH1/OSC_OUT.Signal=RCC_OSC_OUT
PH10.Signal=LTDC_R4
PH11.Signal=LTDC_R5
PH12.Signal=LTDC_R6
PH13.Signal=LTDC_G2
PH14.Signal=LTDC_G3
PH15.Signal=LTDC_G4
PH2.GPIO_Label=BTN2_D
PH2.Signal=GPIO_Input
PH3.GPIO_Label=BTN2_R
PH3.Signal=GPIO_Input
PH6.GPIO_Label=TP_SCK
PH6.Signal=GPIO_Output
PH7.GPIO_Label=TP_PEN
PH7.Signal=GPIO_Input
PH9.Signal=LTDC_R3
PI0.Signal=LTDC_G5
PI1.Signal=LTDC_G6
PI10.Signal=LTDC_HSYNC
PI2.Signal=LTDC_G7
PI3.GPIO_Label=TP_SDA
PI3.Signal=GPIO_Output
PI4.Signal=LTDC_B4
PI5.Signal=LTDC_B5
PI6.Signal=LTDC_B6
PI7.Signal=LTDC_B7
PI8.GPIO_Label=TP_CS
PI8.Signal=GPIO_Output
PI9.Signal=LTDC_VSYNC
