Henry-Loi/Embedded-Game-Console/ELEC3300/Core/Src/main.c

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
/* Includes ------------------------------------------------------------------*/
#include "main.h"

#include "adc.h"
#include "dma.h"
#include "dma2d.h"
#include "fatfs.h"
#include "fmc.h"
#include "gpio.h"
#include "ltdc.h"
#include "sdio.h"

#include "cmsis_os.h"


/* USER CODE BEGIN Includes */
#include "board.h"
#include "gpio.h"
#include "lvgl.h"
#include "os.h"
#include "sdram.h"
#include "ui/lv_boot_animation.h"
#include "user/display/touch.h"


/* USER CODE END Includes */


void SystemClock_Config(void);
void MX_FREERTOS_Init(void);
/* USER CODE BEGIN PFP */
// SDRAM
#define EXT_SDRAM_ADDR ((uint32_t)0xC0000000)
#define EXT_SDRAM_SIZE (32 * 1024 * 1024)

/* USER CODE END PFP */

/* USER CODE BEGIN 0 */

DEFINE_THREAD(led_task, led_blinky);

void led_blinky(void* par) {
	uint32_t last_ticks = 0;

	while (1) {
		osDelay(4);
		if (HAL_GetTick() - last_ticks >= 100) {
			gpio_toggle(LED1);
			last_ticks = HAL_GetTick();
		}
	}
}

DEFINE_THREAD_SIZED(lcd_task, lcd_thread, 4096 * 2);
DEFINE_THREAD(controller_task, buttons_handler);
/* USER CODE END 0 */

/**
 * @brief  The application entry point.
 * @retval int
 */
int main(void) {
	/* MCU Configuration--------------------------------------------------------*/

	/* Reset of all peripherals, Initializes the Flash interface and the Systick. */
	HAL_Init();

	/* Configure the system clock */
	SystemClock_Config();

	/* Initialize all configured peripherals */
	MX_GPIO_Init();
	MX_DMA_Init();
	MX_LTDC_Init();
	MX_FMC_Init();
	MX_DMA2D_Init();
	MX_ADC1_Init();
	MX_SDIO_SD_Init();
	MX_FATFS_Init();
	/* USER CODE BEGIN 2 */

	SDRAM_Init();

	// FATFS
	// fatfs_file_system_test(0);


	/* USER CODE END 2 */

	/* Init scheduler */
	osKernelInitialize(); /* Call init function for freertos objects (in freertos.c) */

	os_create_thread(led_task, NULL, 4);
	os_create_thread(lcd_task, NULL, 1);
	os_create_thread(controller_task, NULL, 3);

	/* Start scheduler */
	osKernelStart();

	/* We should never get here as control is now taken by the scheduler */
	/* Infinite loop */
	/* USER CODE BEGIN WHILE */
	while (1) {
		/* USER CODE END WHILE */

		/* USER CODE BEGIN 3 */
	}
	/* USER CODE END 3 */
}

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
/**
 * @brief  Period elapsed callback in non blocking mode
 * @note   This function is called  when TIM1 interrupt took place, inside
 * HAL_TIM_IRQHandler(). It makes a direct call to HAL_IncTick() to increment
 * a global variable "uwTick" used as application time base.
 * @param  htim : TIM handle
 * @retval None
 */
void HAL_TIM_PeriodElapsedCallback(TIM_HandleTypeDef* htim) {
	if (htim->Instance == TIM1) {
		HAL_IncTick();
	}
}

/**
 * @brief  This function is executed in case of error occurrence.
 * @retval None
 */
void Error_Handler(void) {
	/* USER CODE BEGIN Error_Handler_Debug */
	/* User can add his own implementation to report the HAL error return state */
	__disable_irq();
	while (1) {}
	/* USER CODE END Error_Handler_Debug */
}

#ifdef USE_FULL_ASSERT
/**
 * @brief  Reports the name of the source file and the source line number
 *         where the assert_param error has occurred.
 * @param  file: pointer to the source file name
 * @param  line: assert_param error line source number
 * @retval None
 */
void assert_failed(uint8_t* file, uint32_t line) {
	/* USER CODE BEGIN 6 */
	/* User can add his own implementation to report the file name and line number,
	   ex: printf("Wrong parameters value: file %s on line %d\r\n", file, line) */
	/* USER CODE END 6 */
}
#endif /* USE_FULL_ASSERT */
