Henry-Loi/Embedded-Game-Console/ELEC3300/Core/Inc/main.h

#define SD_Card_Check_Pin GPIO_PIN_2
#define SD_Card_Check_GPIO_Port GPIOE
#define Joy_R_Btn_Pin GPIO_PIN_4
#define Joy_R_Btn_GPIO_Port GPIOE
#define Joy_L_Btn_Pin GPIO_PIN_6
#define Joy_L_Btn_GPIO_Port GPIOE
#define TP_CS_Pin GPIO_PIN_8
#define TP_CS_GPIO_Port GPIOI
#define Btn_Left_Pin GPIO_PIN_13
#define Btn_Left_GPIO_Port GPIOC
#define Btn_Up_Pin GPIO_PIN_0
#define Btn_Up_GPIO_Port GPIOA
#define Btn_Down_Pin GPIO_PIN_2
#define Btn_Down_GPIO_Port GPIOH
#define Btn_Right_Pin GPIO_PIN_3
#define Btn_Right_GPIO_Port GPIOH
#define LED1_Pin GPIO_PIN_1
#define LED1_GPIO_Port GPIOB
#define TP_SCK_Pin GPIO_PIN_6
#define TP_SCK_GPIO_Port GPIOH
#define TP_PEN_Pin GPIO_PIN_7
#define TP_PEN_GPIO_Port GPIOH
#define TP_SDA_Pin GPIO_PIN_3
#define TP_SDA_GPIO_Port GPIOI
#define LCD_BL_Pin GPIO_PIN_5
#define LCD_BL_GPIO_Port GPIOB
#define __forceinline __attribute__((__always_inline__)) inline
