Henry-Loi/Embedded-Game-Console/ELEC3300/Core/Src/user/ltdc_driver.c

#include "ltdc_driver.h"

#include "dma2d.h"

void lcd_backlight_control(uint8_t brightness) {
	if (brightness) {
		// turn on the backlight
		HAL_GPIO_WritePin(LCD_BL_GPIO_PORT, LCD_BL_GPIO_PIN, GPIO_PIN_SET);
	} else {
		// turn off the backlight
		HAL_GPIO_WritePin(LCD_BL_GPIO_PORT, LCD_BL_GPIO_PIN, GPIO_PIN_RESET);
	}
}

void lcd_clear(uint16_t color) {
#if USE_DMA2D_EN
	dma2d_transfer_data_r2m((uint32_t*)LCD_FRAME_BUFFER, LCD_WIDTH, LCD_HEIGHT, 0, color);
#else
	uint16_t* ptr = (uint16_t*)LCD_FRAME_BUFFER;
	uint32_t i = 0;

	while (i++ < LCD_WIDTH * LCD_HEIGHT) {
		*(ptr + i) = color;
	}
#endif /* USE_DMA2D_EN */
}

void lcd_init() {
	lcd_clear(WHITE);
	lcd_backlight_control(255);
}

void lcd_draw_point(uint16_t x, uint16_t y, uint16_t color) {
	uint32_t pos;
	uint16_t* ptr;

	// check position.
	if (x > LCD_WIDTH || y > LCD_HEIGHT) {
		return;
	}

	// calculate the position offset in framebuffer.
	pos = x + y * LCD_WIDTH;
	ptr = (uint16_t*)LCD_FRAME_BUFFER;

	// modify the framebuffer.
#if USE_DMA2D_EN
	dma2d_transfer_data_r2m((uint32_t*)(ptr + pos), 1, 1, 0, color);
#else
	*(ptr + pos) = color;
#endif /* USE_DMA2D_EN */
}

uint16_t lcd_read_point(uint16_t x, uint16_t y) {
	uint32_t pos;
	uint16_t *ptr, data;

	// check position.
	if (x > LCD_WIDTH || y > LCD_HEIGHT) {
		return 0;
	}

	// calculate the position offset in framebuffer.
	pos = x + y * LCD_WIDTH;
	ptr = (uint16_t*)LCD_FRAME_BUFFER;

	// read the framebuffer.
	data = *(ptr + pos);

	return data;
}
