Henry-Loi/Embedded-Game-Console/_My_RGB/User/Config/DEV_Config.h

/*****************************************************************************
* | File      	:   DEV_Config.h
* | Author      :   Waveshare team
* | Function    :   Hardware underlying interface
* | Info        :
*                Used to shield the underlying layers of each master 
*                and enhance portability
*----------------
* |	This version:   V1.0
* | Date        :   2018-11-22
* | Info        :

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
******************************************************************************/
#ifndef __DEV_CONFIG_H
#define __DEV_CONFIG_H

#include "stm32f4xx_hal.h"
#include <stdint.h>
#include <stdio.h>
#include "Debug.h"
#include "main.h"

#define UBYTE   uint8_t
#define UWORD   uint16_t
#define UDOUBLE uint32_t

/**
 * GPIO config
**/
#define DEV_SCL_PIN 	SCL_GPIO_Port,SCL_Pin
#define DEV_SDA_PIN 	SDA_GPIO_Port,SDA_Pin
#define DEV_INT_PIN 	INT_GPIO_Port,INT_Pin
#define DEV_RST_PIN 	RST_GPIO_Port,RST_Pin

#define DEV_BL_PIN			TIM2->CCR4 							//PC7

/**
 * GPIO read and write
**/
#define DEV_Digital_Write(_pin, _value)		HAL_GPIO_WritePin(_pin, _value == 0? GPIO_PIN_RESET:GPIO_PIN_SET)
#define DEV_Digital_Read(_pin)						HAL_GPIO_ReadPin(_pin)

/**
 * delay x ms
**/
#define DEV_Delay_ms(__xms)		HAL_Delay(__xms)
void DEV_Delay_us(UDOUBLE us);

/**
 * PWM_BL
**/

#define DEV_Set_PWM(_Value)		DEV_BL_PIN= _Value

/*-----------------------------------------------------------------------------*/

void DEV_Set_GPIOMode(GPIO_TypeDef* GPIO_Port, UWORD Pin, UWORD mode);
#endif
