Henry-Loi/Embedded-Game-Console/ELEC3300/Core/Src/user/display/lcd_font.h

#pragma once

/**
 * @file lcd_font.h
 * @brief for storing the ASCII font
 **/

// 12 char size
#define LCD_FONT_12_CHAR_WIDTH	6
#define LCD_FONT_12_CHAR_HEIGHT 12
#define LCD_FONT_12_CHAR_SIZE	12

const uint8_t rgblcd_font_12[95][LCD_FONT_12_CHAR_SIZE] = {
	{0x00, 0x00, 0x00, 0x00, 0x00, 0x00, 0x00, 0x00, 0x00, 0x00, 0x00, 0x00}, /* " ",0 */
	{0x00, 0x00, 0x20, 0x20, 0x20, 0x20, 0x20, 0x00, 0x00, 0x20, 0x00, 0x00}, /* "!",1 */
	{0x28, 0x28, 0x50, 0x00, 0x00, 0x00, 0x00, 0x00, 0x00, 0x00, 0x00, 0x00}, /* """,2 */
	{0x00, 0x00, 0x50, 0x50, 0xF8, 0x50, 0x50, 0xF8, 0x50, 0x50, 0x00, 0x00}, /* "#",3 */
	{0x00, 0x20, 0x70, 0xA8, 0xA0, 0x60, 0x30, 0x28, 0xA8, 0x70, 0x20, 0x00}, /* "$",4 */
	{0x00, 0x00, 0x48, 0xA8, 0xB0, 0xA8, 0x74, 0x34, 0x54, 0x48, 0x00, 0x00}, /* "%",5 */
	{0x00, 0x00, 0x20, 0x50, 0x50, 0x6C, 0xA8, 0xA8, 0x94, 0x68, 0x00, 0x00}, /* "&",6 */
	{0x40, 0x40, 0x80, 0x00, 0x00, 0x00, 0x00, 0x00, 0x00, 0x00, 0x00, 0x00}, /* "'",7 */
	{0x08, 0x10, 0x10, 0x20, 0x20, 0x20, 0x20, 0x20, 0x10, 0x10, 0x08, 0x00}, /* "(",8 */
	{0x40, 0x20, 0x20, 0x10, 0x10, 0x10, 0x10, 0x10, 0x20, 0x20, 0x40, 0x00}, /* ")",9 */
	{0x00, 0x00, 0x00, 0x20, 0xA8, 0x70, 0x70, 0xA8, 0x20, 0x00, 0x00, 0x00}, /* "*",10 */
	{0x00, 0x00, 0x00, 0x10, 0x10, 0x7C, 0x10, 0x10, 0x00, 0x00, 0x00, 0x00}, /* "+",11 */
	{0x00, 0x00, 0x00, 0x00, 0x00, 0x00, 0x00, 0x00, 0x40, 0x40, 0x80, 0x00}, /* ",",12 */
	{0x00, 0x00, 0x00, 0x00, 0x00, 0xFC, 0x00, 0x00, 0x00, 0x00, 0x00, 0x00}, /* "-",13 */
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
	 0x01, 0x80, 0x01, 0x80, 0x01, 0x80, 0x01, 0x80, 0x01, 0x80, 0x03, 0x00, 0x03, 0x00, 0x03, 0x00,
	 0x06, 0x00, 0x04, 0x00, 0x0C, 0x00, 0x18, 0x00, 0x10, 0x00, 0x20, 0x00, 0x40, 0x00, 0x00, 0x00}, /* ")",9 */
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
};
