Henry-Loi/Embedded-Game-Console/_My_RGB/Src/sdio_sdcard.c

/**
  ******************************************************************************
  * File Name          : sdio_sdcard.c
  * Description        : 
  ******************************************************************************
  * @attention
  *
  * <h2><center>&copy; Copyright (c) 2020 STMicroelectronics.
  * All rights reserved.</center></h2>
  *
  * This software component is licensed by ST under BSD 3-Clause license,
  * the "License"; You may not use this file except in compliance with the
  * License. You may obtain a copy of the License at:
  *                        opensource.org/licenses/BSD-3-Clause
  *
  ******************************************************************************
  */

/* Includes ------------------------------------------------------------------*/

#include "sdio_sdcard.h"
#include "string.h"

SD_HandleTypeDef        SDCARD_Handler;     				//SD卡句柄
//HAL_SD_CardInfoTypeDef  SDCardInfo;         				//SD卡信息结构体
DMA_HandleTypeDef SDTxDMAHandler,SDRxDMAHandler;    //SD卡DMA发送和接收句柄

//SD_ReadDisk/SD_WriteDisk函数专用buf,当这两个函数的数据缓存区地址不是4字节对齐的时候,
//需要用到该数组,确保数据缓存区地址是4字节对齐的.
__align(4) uint8_t SDIO_DATA_BUFFER[512];

//SD卡初始化
//返回值:0 初始化正确；其他值，初始化错误
uint8_t SD_Init(void)
{
    //初始化时的时钟不能大于400KHZ 
    SDCARD_Handler.Instance=SDIO;
    SDCARD_Handler.Init.ClockEdge=SDIO_CLOCK_EDGE_RISING;          								//上升沿     
    SDCARD_Handler.Init.ClockBypass=SDIO_CLOCK_BYPASS_DISABLE;     								//不使用bypass模式，直接用HCLK进行分频得到SDIO_CK
    SDCARD_Handler.Init.ClockPowerSave=SDIO_CLOCK_POWER_SAVE_DISABLE;    					//空闲时不关闭时钟电源
    SDCARD_Handler.Init.BusWide=SDIO_BUS_WIDE_1B;                       					//1位数据线
    SDCARD_Handler.Init.HardwareFlowControl=SDIO_HARDWARE_FLOW_CONTROL_DISABLE;		//关闭硬件流控
    SDCARD_Handler.Init.ClockDiv=SDIO_TRANSFER_CLK_DIV;            								//SD传输时钟频率最大25MHZ

   
    if(HAL_SD_Init(&SDCARD_Handler) !=HAL_OK)
		{ 
			Error_Handler();
			return 1;
		}
    if(HAL_SD_ConfigWideBusOperation(&SDCARD_Handler,SDIO_BUS_WIDE_4B) !=HAL_OK)//使能宽总线模式
		{
 			Error_Handler();
			return 2;  
		}
    return 0;
}

//SDMMC底层驱动，时钟使能，引脚配置，DMA配置
//此函数会被HAL_SD_Init()调用
//hsd:SD卡句柄
void HAL_SD_MspInit(SD_HandleTypeDef *hsd)
{
    DMA_HandleTypeDef TxDMAHandler,RxDMAHandler;
    GPIO_InitTypeDef GPIO_Initure;
    
    __HAL_RCC_SDIO_CLK_ENABLE();    //使能SDIO时钟
    __HAL_RCC_DMA2_CLK_ENABLE();    //使能DMA2时钟 
    __HAL_RCC_GPIOC_CLK_ENABLE();   //使能GPIOC时钟
    __HAL_RCC_GPIOD_CLK_ENABLE();   //使能GPIOD时钟
    
    //PC8,9,10,11,12
    GPIO_Initure.Pin=GPIO_PIN_8|GPIO_PIN_9|GPIO_PIN_10|GPIO_PIN_11|GPIO_PIN_12;
    GPIO_Initure.Mode=GPIO_MODE_AF_PP;      //推挽复用
    GPIO_Initure.Pull=GPIO_PULLUP;          //上拉
    GPIO_Initure.Speed=GPIO_SPEED_HIGH;     //高速
    GPIO_Initure.Alternate=GPIO_AF12_SDIO;  //复用为SDIO
    HAL_GPIO_Init(GPIOC,&GPIO_Initure);     //初始化
    
    //PD2
    GPIO_Initure.Pin=GPIO_PIN_2;            
    HAL_GPIO_Init(GPIOD,&GPIO_Initure);     //初始化

#if (SD_DMA_MODE==1)                        //使用DMA模式
    HAL_NVIC_SetPriority(SDMMC1_IRQn,2,0);  //配置SDMMC1中断，抢占优先级2，子优先级0
    HAL_NVIC_EnableIRQ(SDMMC1_IRQn);        //使能SDMMC1中断
    
    //配置发送DMA
    SDRxDMAHandler.Instance=DMA2_Stream3;
    SDRxDMAHandler.Init.Channel=DMA_CHANNEL_4;
    SDRxDMAHandler.Init.Direction=DMA_PERIPH_TO_MEMORY;
    SDRxDMAHandler.Init.PeriphInc=DMA_PINC_DISABLE;
    SDRxDMAHandler.Init.MemInc=DMA_MINC_ENABLE;
    SDRxDMAHandler.Init.PeriphDataAlignment=DMA_PDATAALIGN_WORD;
    SDRxDMAHandler.Init.MemDataAlignment=DMA_MDATAALIGN_WORD;
    SDRxDMAHandler.Init.Mode=DMA_PFCTRL;
    SDRxDMAHandler.Init.Priority=DMA_PRIORITY_VERY_HIGH;
    SDRxDMAHandler.Init.FIFOMode=DMA_FIFOMODE_ENABLE;
    SDRxDMAHandler.Init.FIFOThreshold=DMA_FIFO_THRESHOLD_FULL;
    SDRxDMAHandler.Init.MemBurst=DMA_MBURST_INC4;
    SDRxDMAHandler.Init.PeriphBurst=DMA_PBURST_INC4;

    __HAL_LINKDMA(hsd, hdmarx, SDRxDMAHandler); //将接收DMA和SD卡的发送DMA连接起来
    HAL_DMA_DeInit(&SDRxDMAHandler);
    HAL_DMA_Init(&SDRxDMAHandler);              //初始化接收DMA
    
    //配置接收DMA 
    SDTxDMAHandler.Instance=DMA2_Stream6;
    SDTxDMAHandler.Init.Channel=DMA_CHANNEL_4;
    SDTxDMAHandler.Init.Direction=DMA_MEMORY_TO_PERIPH;
    SDTxDMAHandler.Init.PeriphInc=DMA_PINC_DISABLE;
    SDTxDMAHandler.Init.MemInc=DMA_MINC_ENABLE;
    SDTxDMAHandler.Init.PeriphDataAlignment=DMA_PDATAALIGN_WORD;
    SDTxDMAHandler.Init.MemDataAlignment=DMA_MDATAALIGN_WORD;
    SDTxDMAHandler.Init.Mode=DMA_PFCTRL;
    SDTxDMAHandler.Init.Priority=DMA_PRIORITY_VERY_HIGH;
    SDTxDMAHandler.Init.FIFOMode=DMA_FIFOMODE_ENABLE;
    SDTxDMAHandler.Init.FIFOThreshold=DMA_FIFO_THRESHOLD_FULL;
    SDTxDMAHandler.Init.MemBurst=DMA_MBURST_INC4;
    SDTxDMAHandler.Init.PeriphBurst=DMA_PBURST_INC4;
    
    __HAL_LINKDMA(hsd, hdmatx, SDTxDMAHandler);//将发送DMA和SD卡的发送DMA连接起来
    HAL_DMA_DeInit(&SDTxDMAHandler);
    HAL_DMA_Init(&SDTxDMAHandler);              //初始化发送DMA 
  

    HAL_NVIC_SetPriority(DMA2_Stream3_IRQn, 3, 0);  //接收DMA中断优先级
    HAL_NVIC_EnableIRQ(DMA2_Stream3_IRQn);
    HAL_NVIC_SetPriority(DMA2_Stream6_IRQn, 3, 0);  //发送DMA中断优先级
    HAL_NVIC_EnableIRQ(DMA2_Stream6_IRQn);
#endif
}

//得到卡信息
//cardinfo:卡信息存储区
//返回值:错误状态
uint8_t SD_GetCardInfo(HAL_SD_CardInfoTypeDef *cardinfo)
{
    uint8_t sta;
    sta=HAL_SD_GetCardInfo(&SDCARD_Handler,&SDCARD_Handler.SdCard);
    return sta;
}
 #if (SD_DMA_MODE==1)        //DMA模式

//通过DMA读取SD卡一个扇区
//buf:读数据缓存区
//sector:扇区地址
//blocksize:扇区大小(一般都是512字节)
//cnt:扇区个数	
//返回值:错误状态;0,正常;其他,错误代码;
uint8_t SD_ReadBlocks_DMA(uint32_t *buf,uint64_t sector,uint32_t blocksize,uint32_t cnt)
{
    uint8_t err=0;
    err=HAL_SD_ReadBlocks_DMA(&SDCARD_Handler,buf,sector,blocksize,cnt);//通过DMA读取SD卡一个扇区
    if(err==0)//读取成功
    {
        //等待读取完成
        err=HAL_SD_CheckReadOperation(&SDCARD_Handler,(uint32_t)SD_TIMEOUT);
    }

    return err;
}

//写SD卡
//buf:写数据缓存区
//sector:扇区地址
//blocksize:扇区大小(一般都是512字节)
//cnt:扇区个数	
//返回值:错误状态;0,正常;其他,错误代码;	
uint8_t SD_WriteBlocks_DMA(uint32_t *buf,uint64_t sector,uint32_t blocksize,uint32_t cnt)
{
    uint8_t err=0; 
    err=HAL_SD_WriteBlocks_DMA(&SDCARD_Handler,buf,sector,blocksize,cnt);//通过DMA写SD卡一个扇区
    if(err==0)//写成功
    {     
       err=HAL_SD_CheckWriteOperation(&SDCARD_Handler,(uint32_t)SD_TIMEOUT);//等待读取完成/
    }
    return err;
}

//读SD卡
//buf:读数据缓存区
//sector:扇区地址
//cnt:扇区个数	
//返回值:错误状态;0,正常;其他,错误代码;
uint8_t SD_ReadDisk(uint8_t* buf,uint32_t sector,uint32_t cnt)
{
    uint8_t sta=0;
    long long lsector=sector;
    uint8_t n;
    if(SDCardInfo.CardType!=STD_CAPACITY_SD_CARD_V1_1)lsector<<=9;
    if((uint32_t)buf%4!=0)
    {
        for(n=0;n<cnt;n++)
        {
            sta=SD_ReadBlocks_DMA((uint32_t*)SDIO_DATA_BUFFER,lsector+512*n,512,1);
            memcpy(buf,SDIO_DATA_BUFFER,512);
            buf+=512;
        }
    }else
    {
        sta=SD_ReadBlocks_DMA((uint32_t*)buf,lsector, 512,cnt);
    }
    return sta;
}  

//写SD卡
//buf:写数据缓存区
//sector:扇区地址
//cnt:扇区个数	
//返回值:错误状态;0,正常;其他,错误代码;	
uint8_t SD_WriteDisk(uint8_t *buf,uint32_t sector,uint32_t cnt)
{   
    uint8_t sta=0;
    long long lsector=sector;
    uint8_t n;
    if(SDCardInfo.CardType!=STD_CAPACITY_SD_CARD_V1_1)lsector<<=9;
    if((u32)buf%4!=0)
    {
        for(n=0;n<cnt;n++)
        {
            memcpy(SDIO_DATA_BUFFER,buf,512);
            sta=SD_WriteBlocks_DMA((uint32_t*)SDIO_DATA_BUFFER,lsector+512*n,512,1);//单个sector的写操作
            buf+=512;
        }
    }else
    {
        sta=SD_WriteBlocks_DMA((uint32_t*)buf,lsector,512,cnt);//多个sector的写操作
    }
    return sta;
} 

//SDMMC1中断服务函数
void SDMMC1_IRQHandler(void)
{
    HAL_SD_IRQHandler(&SDCARD_Handler);
}

//DMA2数据流6中断服务函数
void DMA2_Stream6_IRQHandler(void)
{
    HAL_DMA_IRQHandler(SDCARD_Handler.hdmatx);
}

//DMA2数据流3中断服务函数
void DMA2_Stream3_IRQHandler(void)
{
    HAL_DMA_IRQHandler(SDCARD_Handler.hdmarx);
}
#else                                   //轮训模式
 
//读SD卡
//buf:读数据缓存区
//sector:扇区地址
//cnt:扇区个数	
//返回值:错误状态;0,正常;其他,错误代码;
uint8_t SD_ReadDisk(uint8_t* buf,uint32_t sector,uint32_t cnt)
{
    uint8_t sta=0;
    long long lsector=sector;
    uint8_t n;
    lsector<<=9;
    INTX_DISABLE();//关闭总中断(POLLING模式,严禁中断打断SDIO读写操作!!!)
    if((uint32_t)buf%4!=0)
    {
        for(n=0;n<cnt;n++)
        {
            sta=HAL_SD_ReadBlocks(&SDCARD_Handler,SDIO_DATA_BUFFER,lsector+512*n,512,1);//单个sector的读操作
            memcpy(buf,SDIO_DATA_BUFFER,512);
            buf+=512;
        }
    }else
    {
        sta=HAL_SD_ReadBlocks(&SDCARD_Handler,buf,lsector,512,cnt);//单个sector的读操作
    }
    INTX_ENABLE();//开启总中断
    return sta;
}  

//写SD卡
//buf:写数据缓存区
//sector:扇区地址
//cnt:扇区个数	
//返回值:错误状态;0,正常;其他,错误代码;	
uint8_t SD_WriteDisk(uint8_t *buf,uint32_t sector,uint32_t cnt)
{   
    uint8_t sta=0;
    long long lsector=sector;
    uint8_t n;
    lsector<<=9;
    INTX_DISABLE();//关闭总中断(POLLING模式,严禁中断打断SDIO读写操作!!!)
    if((uint32_t)buf%4!=0)
    {
        for(n=0;n<cnt;n++)
        {
            memcpy(SDIO_DATA_BUFFER,buf,512);
            sta=HAL_SD_WriteBlocks(&SDCARD_Handler,SDIO_DATA_BUFFER,lsector+512*n,512,1);//单个sector的写操作
            buf+=512;
        }
    }else
    {
        sta=HAL_SD_WriteBlocks(&SDCARD_Handler,buf,lsector,512,cnt);//多个sector的写操作
    }
	INTX_ENABLE();//开启总中断
    return sta;
}
#endif
