Henry-Loi/Embedded-Game-Console/_My_RGB/Src/fatfs.c

/**
  ******************************************************************************
  * @file   fatfs.c
  * @brief  Code for fatfs applications
  ******************************************************************************
  * @attention
  *
  * <h2><center>&copy; Copyright (c) 2020 STMicroelectronics.
  * All rights reserved.</center></h2>
  *
  * This software component is licensed by ST under Ultimate Liberty license
  * SLA0044, the "License"; You may not use this file except in compliance with
  * the License. You may obtain a copy of the License at:
  *                             www.st.com/SLA0044
  *
  ******************************************************************************
  */

#include "fatfs.h"

uint8_t retSD;    /* Return value for SD */
char SDPath[4];   /* SD logical drive path */
FATFS SDFatFS;    /* File system object for SD logical drive */
FIL SDFile;       /* File object for SD */

/* USER CODE BEGIN Variables */

#include "sys.h"
#include "stdio.h"
#include "malloc.h"

UINT br,bw;			//读写变量
FILINFO fileinfo;	//文件信息
DIR dir;  			//目录

u8 *fatbuf;			//SD卡数据缓存区

/* USER CODE END Variables */    

void MX_FATFS_Init(void) 
{
  /*## FatFS: Link the SD driver ###########################*/
  retSD = FATFS_LinkDriver(&SD_Driver, SDPath);

  /* USER CODE BEGIN Init */
  /* additional user code for init */     
  /* USER CODE END Init */
}

/**
  * @brief  Gets Time from RTC 
  * @param  None
  * @retval Time in DWORD
  */
DWORD get_fattime(void)
{
  /* USER CODE BEGIN get_fattime */
  return 0;
  /* USER CODE END get_fattime */  
}

/* USER CODE BEGIN Application */
     


u8 exfuns_init(void)
{
	fatbuf=(u8*)mymalloc(SRAMIN,512);				//为fatbuf申请内存
	if(fatbuf)return 0;  //申请有一个失败,即失败.
	else return 1;	
}


//为磁盘注册工作区	 
//path:磁盘路径，比如"0:"、"1:"
//mt:0，不立即注册（稍后注册）；1，立即注册
//返回值:执行结果
u8 mf_mount(u8* path,u8 mt)
{		   
	return f_mount(&SDFatFS,(const TCHAR*)path,mt); 
}
//打开路径下的文件
//path:路径+文件名
//mode:打开模式
//返回值:执行结果
u8 mf_open(u8*path,u8 mode)
{
	u8 res;	 
	res=f_open(&SDFile,(const TCHAR*)path,mode);//打开文件夹
	return res;
} 
//关闭文件
//返回值:执行结果
u8 mf_close(void)
{
	f_close(&SDFile);
	return 0;
}
//读出数据
//len:读出的长度
//返回值:执行结果
u8 mf_read(u16 len)
{
	u16 i,t;
	u8 res=0;
	u16 tlen=0;
	printf("\r\nRead file data is:\r\n");
	for(i=0;i<len/512;i++)
	{
		res=f_read(&SDFile,fatbuf,512,&br);
		if(res)
		{
			printf("Read Error:%d\r\n",res);
			break;
		}else
		{
			tlen+=br;
			for(t=0;t<br;t++)printf("%c",fatbuf[t]); 
		}
	}
	if(len%512)
	{
		res=f_read(&SDFile,fatbuf,len%512,&br);
		if(res)	//读数据出错了
		{
			printf("\r\nRead Error:%d\r\n",res);   
		}else
		{
			tlen+=br;
			for(t=0;t<br;t++)printf("%c",fatbuf[t]); 
		}	 
	}
	if(tlen)printf("\r\nReaded data len:%d\r\n",tlen);//读到的数据长度
	printf("Read data over\r\n");	 
	return res;
}
//写入数据
//dat:数据缓存区
//len:写入长度
//返回值:执行结果
u8 mf_write(u8*dat,u16 len)
{			    
	u8 res;	   					   

	printf("\r\nBegin Write file...\r\n");
	printf("Write data len:%d\r\n",len);	 
	res=f_write(&SDFile,dat,len,&bw);
	if(res)
	{
		printf("Write Error:%d\r\n",res);   
	}else printf("Writed data len:%d\r\n",bw);
	printf("Write data over.\r\n");
	return res;
}

//打开目录
 //path:路径
//返回值:执行结果
u8 mf_opendir(u8* path)
{
	return f_opendir(&dir,(const TCHAR*)path);	
}
//关闭目录 
//返回值:执行结果
u8 mf_closedir(void)
{
	return f_closedir(&dir);	
}
//打读取文件夹
//返回值:执行结果
u8 mf_readdir(void)
{
	u8 res;    
	res=f_readdir(&dir,&fileinfo);	//读取一个文件的信息
	if(res!=FR_OK)return res;		//出错了 
	printf("\r\n DIR info:\r\n");

	printf("dir.dptr:%ld\r\n",dir.dptr);
	printf("dir.obj.id:%d\r\n",dir.obj.id);
	printf("dir.obj.sclust:%ld\r\n",dir.obj.sclust);
	printf("dir.obj.objsize:%ld\r\n",dir.obj.objsize);
//	printf("dir.obj.c_ofs:%d\r\n",(uint32_t)dir.obj.c_ofs);
	printf("dir.clust:%ld\r\n",dir.clust);
	printf("dir.sect:%ld\r\n",dir.sect);	  
	printf("dir.blk_ofs:%ld\r\n",dir.blk_ofs);	  

	printf("\r\n");
	printf("File Name is:%s\r\n",fileinfo.fname);
	printf("File Size is:%ld\r\n",fileinfo.fsize);
	printf("File data is:%d\r\n",fileinfo.fdate);
	printf("File time is:%d\r\n",fileinfo.ftime);
	printf("File Attr is:%d\r\n",fileinfo.fattrib);
	printf("\r\n"); 
	return 0;
}			 

 //遍历文件
 //path:路径
 //返回值:执行结果
u8 mf_scan_files(u8 * path)
{
	FRESULT res;	 
    res = f_opendir(&dir,(const TCHAR*)path); //打开一个目录
    if (res == FR_OK) 
	{	
		printf("\r\n"); 
		while(1)
		{
	        res = f_readdir(&dir, &fileinfo);                   //读取目录下的一个文件
	        if (res != FR_OK || fileinfo.fname[0] == 0) break;  //错误了/到末尾了,退出
	        //if (fileinfo.fname[0] == '.') continue;             //忽略上级目录
 			printf("%s/", path);//打印路径	
			printf("%s\r\n",fileinfo.fname);//打印文件名	  
		} 
    }	   
    return res;	  
}
//显示剩余容量
//drv:盘符
//返回值:剩余容量(字节)
u32 mf_showfree(u8 *drv)
{
	FATFS *fs1;
	u8 res;
    u32 fre_clust=0, fre_sect=0, tot_sect=0;
    //得到磁盘信息及空闲簇数量
    res = f_getfree((const TCHAR*)drv,(DWORD*)&fre_clust, &fs1);
    if(res==0)
	{											   
	    tot_sect = (fs1->n_fatent - 2) * fs1->csize;//得到总扇区数
	    fre_sect = fre_clust * fs1->csize;			//得到空闲扇区数	   
#if _MAX_SS!=512
		tot_sect*=fs1->ssize/512;
		fre_sect*=fs1->ssize/512;
#endif	  
		if(tot_sect<20480)//总容量小于10M
		{
		    /* Print free space in unit of KB (assuming 512 bytes/sector) */
		    printf("\r\n磁盘总容量:%d KB\r\n"
		           "可用空间:%d KB\r\n",
		           tot_sect>>1,fre_sect>>1);
		}else
		{
		    /* Print free space in unit of KB (assuming 512 bytes/sector) */
		    printf("\r\n磁盘总容量:%d MB\r\n"
		           "可用空间:%d MB\r\n",
		           tot_sect>>11,fre_sect>>11);
		}
	}
	return fre_sect;
}		    
//文件读写指针偏移
//offset:相对首地址的偏移量
//返回值:执行结果.
u8 mf_lseek(u32 offset)
{
	return f_lseek(&SDFile,offset);
}
//读取文件当前读写指针的位置.
//返回值:位置
u32 mf_tell(void)
{
	return f_tell(&SDFile);
}
//读取文件大小
//返回值:文件大小
u32 mf_size(void)
{
	return f_size(&SDFile);
} 
//创建目录
//pname:目录路径+名字
//返回值:执行结果
u8 mf_mkdir(u8*pname)
{
	return f_mkdir((const TCHAR *)pname);
}
//格式化
//path:磁盘路径，比如"0:"、"1:"
//mode:模式
//au:簇大小
//返回值:执行结果
//u8 mf_fmkfs(u8* path,u8 mode,u16 au)
//{
//	return f_mkfs((const TCHAR*)path,mode,au);//格式化,drv:盘符;mode:模式;au:簇大小
//} 
//删除文件/目录
//pname:文件/目录路径+名字
//返回值:执行结果
u8 mf_unlink(u8 *pname)
{
	return  f_unlink((const TCHAR *)pname);
}

//修改文件/目录名字(如果目录不同,还可以移动文件哦!)
//oldname:之前的名字
//newname:新名字
//返回值:执行结果
u8 mf_rename(u8 *oldname,u8* newname)
{
	return  f_rename((const TCHAR *)oldname,(const TCHAR *)newname);
}
//获取盘符（磁盘名字）
//path:磁盘路径，比如"0:"、"1:"  
void mf_getlabel(u8 *path)
{
//	u8 buf[20];
//	u32 sn=0;
//	u8 res;
//	res=f_getlabel ((const TCHAR *)path,(TCHAR *)buf,(DWORD*)&sn);
//	if(res==FR_OK)
//	{
//		printf("\r\n磁盘%s 的盘符为:%s\r\n",path,buf);
//		printf("磁盘%s 的序列号:%X\r\n\r\n",path,sn); 
//	}else printf("\r\n获取失败，错误码:%X\r\n",res);
}
//设置盘符（磁盘名字），最长11个字符！！，支持数字和大写字母组合以及汉字等
//path:磁盘号+名字，比如"0:ALIENTEK"、"1:OPENEDV"  
void mf_setlabel(u8 *path)
{
//	u8 res;
//	res=f_setlabel ((const TCHAR *)path);
//	if(res==FR_OK)
//	{
//		printf("\r\n磁盘盘符设置成功:%s\r\n",path);
//	}else printf("\r\n磁盘盘符设置失败，错误码:%X\r\n",res);
} 

//从文件里面读取一段字符串
//size:要读取的长度
void mf_gets(u16 size)
{
 	TCHAR* rbuf;
	rbuf=f_gets((TCHAR*)fatbuf,size,&SDFile);
	if(*rbuf==0)return  ;//没有数据读到
	else
	{
		printf("\r\nThe String Readed Is:%s\r\n",rbuf);  	  
	}			    	
}
//需要_USE_STRFUNC>=1
//写一个字符到文件
//c:要写入的字符
//返回值:执行结果
u8 mf_putc(u8 c)
{
	return f_putc((TCHAR)c,&SDFile);
}
//写字符串到文件
//c:要写入的字符串
//返回值:写入的字符串长度
u8 mf_puts(u8*c)
{
	return f_puts((TCHAR*)c,&SDFile);
}

































/* USER CODE END Application */

/************************ (C) COPYRIGHT STMicroelectronics *****END OF FILE****/
