Henry-Loi/Embedded-Game-Console/ELEC3300/Core/Src/img.c

/**
 * Made with Marlin RGB565 Converter
 * https://marlinfw.org/tools/rgb565/converter.html
 *
 * This bitmap from the file 'roboticsteam.png'
 */
// #include "../../../inc/MarlinConfigPre.h"

// #if HAS_GRAPHICAL_TFT
// #include <stdint.h>

// uint16_t image_data_20x20x16[400] = {
// 	0x0000, 0x0000, 0x0000, 0x0000, 0x0000, 0x0000, 0x0000, 0x0000, 0x0000, 0x0000, 0x0000, 0x0000, 0x0000, 0x0000,
// 	0x0000, 0x0000, 0x0000, 0x0000, 0x0000, 0x0000, 0x0000, 0x0000, 0x0000, 0x0000, 0x0000, 0x0000, 0x0000, 0x0000,
// 	0x0000, 0x0000, 0x0000, 0x0000, 0x0000, 0x0000, 0x0000, 0x0000, 0x0000, 0x0000, 0x0000, 0x0000, 0x0000, 0x0000,
// 	0x0000, 0x0000, 0x0000, 0x0000, 0x0000, 0x0000, 0x0000, 0x0000, 0x0000, 0x0000, 0x0000, 0x0000, 0x0000, 0x0000,
// 	0x0000, 0x0000, 0x0000, 0x0000, 0x0000, 0x0000, 0x0000, 0x0000, 0x0000, 0x0000, 0x0000, 0x0000, 0x0000, 0x0000,
// 	0x0000, 0x0000, 0x0000, 0x0000, 0x0000, 0x0000, 0x0000, 0x0000, 0x0000, 0x0000, 0x0000, 0x0000, 0x0000, 0x0000,
// 	0x0000, 0x0020, 0x0020, 0x0000, 0x0000, 0x0000, 0x0000, 0x0000, 0x0000, 0x0000, 0x0000, 0x0000, 0x0000, 0x0000,
// 	0x0000, 0x0000, 0x0000, 0x0000, 0x0000, 0x0000, 0x0000, 0x0000, 0x0000, 0x0000, 0x0000, 0x0000, 0x0000, 0x0000,
// 	0x0000, 0x0000, 0x0000, 0x0020, 0x0020, 0x0000, 0x0000, 0x0000, 0x0000, 0x0000, 0x0000, 0x0000, 0x81C7, 0xC410,
// 	0xBBEF, 0xB249, 0x78E3, 0x9D14, 0x8C30, 0x8C51, 0x7BEF, 0x8C71, 0x7BCF, 0xAD75, 0x8410, 0x0000, 0x0000, 0x0000,
// 	0x0000, 0x0000, 0x0000, 0x1000, 0xF659, 0xECD3, 0xEDB6, 0xFEDB, 0x8A69, 0xCEBA, 0xA514, 0xAD75, 0xA534, 0xB5B6,
// 	0x9492, 0x7BEF, 0x2124, 0x0000, 0x0000, 0x0000, 0x0000, 0x0000, 0x0000, 0x61E7, 0xFE59, 0xE4F3, 0xFF5D, 0xCB8E,
// 	0x20C3, 0x2124, 0x20E3, 0x18E3, 0x2965, 0x31A6, 0x1082, 0x18C3, 0x0000, 0x0000, 0x0000, 0x0000, 0x0000, 0x0000,
// 	0x0000, 0x9BCF, 0xCC30, 0xA9C7, 0xDE38, 0x81C7, 0x6B4D, 0x7BCF, 0x738E, 0x6B6D, 0x31A6, 0x6B6D, 0x73AE, 0x6B4D,
// 	0x0841, 0x0000, 0x0000, 0x0000, 0x0000, 0x0000, 0x0000, 0x3124, 0x3904, 0x2800, 0x41C7, 0x28C3, 0x2124, 0x2965,
// 	0x2124, 0x2945, 0x10A2, 0x2124, 0x2965, 0x2124, 0x0000, 0x0000, 0x0000, 0x0000, 0x0000, 0x0000, 0x0000, 0x1061,
// 	0x3965, 0x3124, 0x39A6, 0x2882, 0x0000, 0x0020, 0x0020, 0x0000, 0x0020, 0x0841, 0x0000, 0x0000, 0x0000, 0x0000,
// 	0x0000, 0x0000, 0x0000, 0x0000, 0x0000, 0x0000, 0x2104, 0x2082, 0x20C3, 0x2104, 0x1041, 0x18E3, 0x18C3, 0x18C3,
// 	0x18C3, 0x18C3, 0x10A2, 0x1082, 0x0020, 0x0000, 0x0000, 0x0000, 0x0000, 0x0000, 0x0000, 0x0000, 0x0841, 0x1082,
// 	0x1082, 0x1041, 0x0800, 0x1082, 0x0861, 0x1082, 0x0861, 0x0861, 0x0861, 0x1082, 0x0841, 0x0000, 0x0000, 0x0000,
// 	0x0000, 0x0000, 0x0000, 0x0000, 0x0000, 0x0000, 0x0000, 0x0000, 0x0000, 0x0000, 0x0000, 0x0000, 0x0000, 0x0000,
// 	0x0000, 0x0000, 0x0000, 0x0000, 0x0000, 0x0000, 0x0000, 0x0000, 0x0000, 0x0000, 0x0000, 0x0000, 0x0000, 0x0000,
// 	0x0000, 0x0000, 0x0000, 0x0000, 0x0000, 0x0000, 0x0000, 0x0000, 0x0000, 0x0000, 0x0000, 0x0000, 0x0000, 0x0000,
// 	0x0000, 0x0000, 0x0000, 0x0000, 0x0000, 0x0000, 0x0000, 0x0000, 0x0000, 0x0000, 0x0000, 0x0000, 0x0000, 0x0000,
// 	0x0000, 0x0000, 0x0000, 0x0000, 0x0000, 0x0000, 0x0000, 0x0000, 0x0000, 0x0000, 0x0000, 0x0000, 0x0000, 0x0000,
// 	0x0000, 0x0000, 0x0000, 0x0000, 0x0000, 0x0000, 0x0000, 0x0000, 0x0000, 0x0000, 0x0000, 0x0000, 0x0000, 0x0000,
// 	0x0000, 0x0000, 0x0000, 0x0000, 0x0000, 0x0000, 0x0000, 0x0000, 0x0000, 0x0000, 0x0000, 0x0000, 0x0000, 0x0000,
// 	0x0000, 0x0000, 0x0000, 0x0000, 0x0000, 0x0000, 0x0000, 0x0000, 0x0000, 0x0000, 0x0000, 0x0000, 0x0000, 0x0000,
// 	0x0000, 0x0000, 0x0000, 0x0000, 0x0000, 0x0000, 0x0000, 0x0000};
