Henry-Loi/Embedded-Game-Console/_My_RGB/Inc/decode.h

/**
  ******************************************************************************
  * @file    LibJPEG/LibJPEG_Decoding/Inc/decode.h 
  * @author  MCD Application Team
  * @brief   header of decode.c file
  ******************************************************************************
  * @attention
  *
  * <h2><center>&copy; Copyright (c) 2017 STMicroelectronics International N.V. 
  * All rights reserved.</center></h2>
  *
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
  ******************************************************************************
  */
/* Define to prevent recursive inclusion -------------------------------------*/
#ifndef __DECODE_H
#define __DECODE_H

/* Includes ------------------------------------------------------------------*/
#include "main.h"

/**/
#include "jdata_conf.h"
/* Private typedef -----------------------------------------------------------*/
/* Private define ------------------------------------------------------------*/
/* Private macro -------------------------------------------------------------*/
/* Private variables ---------------------------------------------------------*/
/* Private function prototypes -----------------------------------------------*/
/* Private functions ---------------------------------------------------------*/


void jpeg_decode(JFILE *file, uint32_t width, uint8_t * buff, uint8_t (*callback)(uint8_t*, uint32_t));

#endif /* __DECODE_H */

/************************ (C) COPYRIGHT STMicroelectronics *****END OF FILE****/
