Henry-Loi/Embedded-Game-Console/ELEC3300/Core/Src/user/tft.c

#include "controller.h"
#include "diskio.h"
#include "display/lcd.h"
#include "display/touch.h"
#include "lcd.h"
#include "lv_conf.h"
#include "lv_demo_widgets.h"
#include "lv_os.h"
#include "os.h"
#include "sd_diskio.h"
#include "ui/lv_boot_animation.h"
#include "ui/navbar.h"

#define USE_OWN_TFT 0

// touch point testing code
int touch_screen_test(int r) {
	for (int i = 0; i < MAX_TOUCH_POINTS; i++) {
		tft_prints(0, r++, "POINT %d: ", i + 1);
		tft_prints(0, r++, "x: %d", touch_feedback.point[i].x);
		tft_prints(0, r++, "y: %d", touch_feedback.point[i].y);
	}
	tft_prints(0, r++, "NUM OF PRESSES: %d", touch_feedback.pressed_state);
	return r;
}

DSTATUS SD_status(BYTE);

void lcd_thread(void* par) {
	// lcd init
	lcd_init();
	touch_init();

	QueueHandle_t MutexSemaphore = xSemaphoreCreateMutex();

	if (!USE_OWN_TFT) {
		// lvgl init function calls
		lv_init();
		lv_port_disp_init();  /* lvgl lcd display init */
		lv_port_indev_init(); /* lvgl lcd touch screen init */

		lv_boot_animation(lv_init_icon, 5000);

		uint32_t last_ticks = get_ticks();
		// hold everything else until bar renders
		while (get_ticks() - last_ticks < 5000) {
			xSemaphoreTake(MutexSemaphore, portMAX_DELAY);
			lv_task_handler();
			xSemaphoreGive(MutexSemaphore);
		}

		// actual stuff
		render_navbar();
	}

	while (1) {
		osDelay(4);

		if (!USE_OWN_TFT) {
			// lv task handler
			xSemaphoreTake(MutexSemaphore, portMAX_DELAY);
			lv_task_handler();
			xSemaphoreGive(MutexSemaphore);
		}


		else {
			int r = 0;
			tft_prints(0, r++, "%02d:%02d.%02d", (int)get_ticks() / 60000, ((int)get_ticks() / 1000) % 60,
					   ((int)get_ticks() % 1000) / 10);

			r++;
			r = touch_screen_test(r);
			r++;
			r = controller_tft(r);

			tft_update();
		}
		touch_update();
	}
}
