Henry-Loi/Embedded-Game-Console/ELEC3300/Core/Src/dma2d.c

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
/* Includes ------------------------------------------------------------------*/
#include "dma2d.h"

/* USER CODE BEGIN 0 */
#include "user/display/lcd.h"
/* USER CODE END 0 */

DMA2D_HandleTypeDef hdma2d;

/* DMA2D init function */
void MX_DMA2D_Init(void)
{

  hdma2d.Instance = DMA2D;
  hdma2d.Init.Mode = DMA2D_R2M;
  hdma2d.Init.ColorMode = DMA2D_OUTPUT_RGB565;
  hdma2d.Init.OutputOffset = 0;
  if (HAL_DMA2D_Init(&hdma2d) != HAL_OK)
  {
    Error_Handler();
  }
}

void HAL_DMA2D_MspInit(DMA2D_HandleTypeDef* dma2dHandle)
{

  if(dma2dHandle->Instance==DMA2D)
  {
    /* DMA2D clock enable */
    __HAL_RCC_DMA2D_CLK_ENABLE();
  }
}

void HAL_DMA2D_MspDeInit(DMA2D_HandleTypeDef* dma2dHandle)
{

  if(dma2dHandle->Instance==DMA2D)
  {
    /* Peripheral clock disable */
    __HAL_RCC_DMA2D_CLK_DISABLE();
  }
}

/* USER CODE BEGIN 1 */
void dma2d_transfer_data_r2m(uint32_t* addr, uint32_t xSize, uint32_t ySize, uint32_t offsetLine, uint16_t color) {
	DMA2D->CR = DMA2D_R2M; // dma2d mode: register to memory.
	DMA2D->OPFCCR = DMA2D_OUTPUT_RGB565;

	DMA2D->OCOLR = color;
	DMA2D->OMAR = (uint32_t)addr;
	DMA2D->OOR = offsetLine;
	DMA2D->NLR = (uint32_t)(xSize << 16) | (uint16_t)ySize;

	DMA2D->CR |= DMA2D_CR_START;
	while (DMA2D->CR & DMA2D_CR_START)
		;
}

/* USER CODE END 1 */
