Henry-Loi/Embedded-Game-Console/ELEC3300/Core/Src/user/display/i2c.h

#ifndef _I2C_H_
#define _I2C_H_

#include "main.h"

/******************************************************************************************/
/* 引脚 定义 */

#define IIC_SCL_GPIO_PORT GPIOH
#define IIC_SCL_GPIO_PIN  GPIO_PIN_6
#define IIC_SCL_GPIO_CLK_ENABLE()     \
	do {                              \
		__HAL_RCC_GPIOB_CLK_ENABLE(); \
	} while (0) /* PB口时钟使能 */

#define IIC_SDA_GPIO_PORT GPIOI
#define IIC_SDA_GPIO_PIN  GPIO_PIN_3
#define IIC_SDA_GPIO_CLK_ENABLE()     \
	do {                              \
		__HAL_RCC_GPIOB_CLK_ENABLE(); \
	} while (0) /* PB口时钟使能 */

/******************************************************************************************/

/* IO操作 */
#define IIC_SCL(x)                                                                  \
	do {                                                                            \
		x ? HAL_GPIO_WritePin(IIC_SCL_GPIO_PORT, IIC_SCL_GPIO_PIN, GPIO_PIN_SET)    \
		  : HAL_GPIO_WritePin(IIC_SCL_GPIO_PORT, IIC_SCL_GPIO_PIN, GPIO_PIN_RESET); \
	} while (0) /* SCL */

#define IIC_SDA(x)                                                                  \
	do {                                                                            \
		x ? HAL_GPIO_WritePin(IIC_SDA_GPIO_PORT, IIC_SDA_GPIO_PIN, GPIO_PIN_SET)    \
		  : HAL_GPIO_WritePin(IIC_SDA_GPIO_PORT, IIC_SDA_GPIO_PIN, GPIO_PIN_RESET); \
	} while (0) /* SDA */

#define IIC_READ_SDA HAL_GPIO_ReadPin(IIC_SDA_GPIO_PORT, IIC_SDA_GPIO_PIN) /* 读取SDA */

void soft_IIC_Init(void);													 /* 初始化IIC的IO口 */
void iic_start(void);														 /* 发送IIC开始信号 */
void iic_stop(void);														 /* 发送IIC停止信号 */
void iic_ack(void);															 /* IIC发送ACK信号 */
void iic_nack(void);														 /* IIC不发送ACK信号 */
uint8_t iic_wait_ack(void);													 /* IIC等待ACK信号 */
void iic_send_byte(uint8_t txd);											 /* IIC发送一个字节 */
uint8_t iic_read_byte(unsigned char ack);									 /* IIC读取一个字节 */
uint8_t IIC_Read_Len(uint8_t addr, uint8_t reg, uint8_t len, uint8_t* buf);	 /* 连续读取多个字节 */
uint8_t IIC_Write_Len(uint8_t addr, uint8_t reg, uint8_t len, uint8_t* buf); /* 连续写入多个字节 */

#endif /* _I2C_H_ */
