Henry-Loi/Embedded-Game-Console/_My_RGB/Inc/fatfs.h

/**
  ******************************************************************************
  * @file   fatfs.h
  * @brief  Header for fatfs applications
  ******************************************************************************
  * @attention
  *
  * <h2><center>&copy; Copyright (c) 2020 STMicroelectronics.
  * All rights reserved.</center></h2>
  *
  * This software component is licensed by ST under Ultimate Liberty license
  * SLA0044, the "License"; You may not use this file except in compliance with
  * the License. You may obtain a copy of the License at:
  *                             www.st.com/SLA0044
  *
  ******************************************************************************
  */

/* Define to prevent recursive inclusion -------------------------------------*/
#ifndef __fatfs_H
#define __fatfs_H
#ifdef __cplusplus
 extern "C" {
#endif

#include "ff.h"
#include "ff_gen_drv.h"
#include "sd_diskio.h" /* defines SD_Driver as external */

/* USER CODE BEGIN Includes */
#include "sys.h"
/* USER CODE END Includes */

extern uint8_t retSD; /* Return value for SD */
extern char SDPath[4]; /* SD logical drive path */
extern FATFS SDFatFS; /* File system object for SD logical drive */
extern FIL SDFile; /* File object for SD */

void MX_FATFS_Init(void);

/* USER CODE BEGIN Prototypes */
	 
	 
	 
	 
	 
	 
	 
u8 exfuns_init(void);
u8 mf_mount(u8* path,u8 mt);
u8 mf_open(u8*path,u8 mode);
u8 mf_close(void);
u8 mf_read(u16 len);
u8 mf_write(u8*dat,u16 len);
u8 mf_opendir(u8* path);
u8 mf_closedir(void);
u8 mf_readdir(void);
u8 mf_scan_files(u8 * path);
u32 mf_showfree(u8 *drv);
u8 mf_lseek(u32 offset);
u32 mf_tell(void);
u32 mf_size(void);
u8 mf_mkdir(u8*pname);
u8 mf_fmkfs(u8* path,u8 mode,u16 au);
u8 mf_unlink(u8 *pname);
u8 mf_rename(u8 *oldname,u8* newname);
void mf_getlabel(u8 *path);
void mf_setlabel(u8 *path); 
void mf_gets(u16 size);
u8 mf_putc(u8 c);
u8 mf_puts(u8*c);






/* USER CODE END Prototypes */
#ifdef __cplusplus
}
#endif
#endif /*__fatfs_H */

/************************ (C) COPYRIGHT STMicroelectronics *****END OF FILE****/
