Henry-Loi/Embedded-Game-Console/LTDC_Martin_Test/Core/Inc/LCD_LTDC.h

#ifndef INC_LCD_LTDC_H_
#define INC_LCD_LTDC_H_

#include "sdram.h"


typedef struct
{
  int16_t X;
  int16_t Y;
}Point, * pPoint;


#define MAX_LAYER_NUMBER       ((uint32_t)2)

#define LCD_LayerCfgTypeDef    LTDC_LayerCfgTypeDef

#define LTDC_ACTIVE_LAYER	     ((uint32_t)1) /* Layer 1 */
/**
  * @brief  LCD status structure definition
  */
#define LCD_OK                 ((uint8_t)0x00)
#define LCD_ERROR              ((uint8_t)0x01)
#define LCD_TIMEOUT            ((uint8_t)0x02)

#define LCD_WIDTH 1024
#define LCD_HEIGHT 600

/**
  * @brief  LCD FB_StartAddress
  */
//#define LCD_FB_START_ADDRESS       ((uint32_t)0xD0000000)

/**
  * @brief  LCD color
  */
/* --------------------------------RGB565 -------------------------------------*/
#define LCD_COLOR_BLUE          0x001F
#define LCD_COLOR_GREEN         0x07E0
#define LCD_COLOR_RED           0xF800
#define LCD_COLOR_CYAN          0x07FF
#define LCD_COLOR_MAGENTA       0xF81F
#define LCD_COLOR_YELLOW        0xFFE0
#define LCD_COLOR_LIGHTBLUE     0x841F
#define LCD_COLOR_LIGHTGREEN    0x87F0
#define LCD_COLOR_LIGHTRED      0xFC10
#define LCD_COLOR_LIGHTCYAN     0x87FF
#define LCD_COLOR_LIGHTMAGENTA  0xFC1F
#define LCD_COLOR_LIGHTYELLOW   0xFFF0
#define LCD_COLOR_DARKBLUE      0x0010
#define LCD_COLOR_DARKGREEN     0x0400
#define LCD_COLOR_DARKRED       0x8000
#define LCD_COLOR_DARKCYAN      0x0410
#define LCD_COLOR_DARKMAGENTA   0x8010
#define LCD_COLOR_DARKYELLOW    0x8400
#define LCD_COLOR_WHITE         0xFFFF
#define LCD_COLOR_LIGHTGRAY     0xD69A
#define LCD_COLOR_GRAY          0x8410
#define LCD_COLOR_DARKGRAY      0x4208
#define LCD_COLOR_BLACK         0x0000
#define LCD_COLOR_BROWN         0xA145
#define LCD_COLOR_ORANGE        0xFD20


/** @addtogroup STM32746G_DISCOVERY_LCD_Exported_Functions
  * @{
  */
uint8_t  BSP_LCD_Init(void);

uint32_t BSP_LCD_GetXSize(void);
uint32_t BSP_LCD_GetYSize(void);


/* Functions using the LTDC controller */
void     BSP_LCD_SetTransparency(uint32_t LayerIndex, uint8_t Transparency);
void     BSP_LCD_SetLayerAddress(uint32_t LayerIndex, uint32_t Address);
void     BSP_LCD_SetColorKeying(uint32_t LayerIndex, uint32_t RGBValue);
void     BSP_LCD_ResetColorKeying(uint32_t LayerIndex);
void     BSP_LCD_SetLayerWindow(uint16_t LayerIndex, uint16_t Xpos, uint16_t Ypos, uint16_t Width, uint16_t Height);

void     BSP_LCD_SelectLayer(uint32_t LayerIndex);
void     BSP_LCD_SetLayerVisible(uint32_t LayerIndex, FunctionalState State);

uint32_t BSP_LCD_ReadPixel(uint16_t Xpos, uint16_t Ypos);
void     BSP_LCD_DrawPixel(uint16_t Xpos, uint16_t Ypos, uint32_t pixel);
void     BSP_LCD_Clear(uint32_t Color);


#ifdef __cplusplus
}
#endif

#endif
