Henry-Loi/Embedded-Game-Console/(commit log)

2023-09-30 Setup .ioc
    STM32F429RGT6 Basic Setup
2023-10-11 Revert "add lvgl submodule"
    This reverts commit a9932f689c38373ef1fa65db0fb73adc1e56ff12.
    [lv_os.h]
2023-10-11 switch to stable version v.8.3
2023-10-12 push simply led blinky code
    [LTDC_Dailo_Project Debug.cfg]
2023-10-12 led blinky code done
    [LTDC_Dailo_Project Debug.cfg]
2023-10-16 LCD light on
    [LTDC_Martin_Test Debug.cfg]
2023-10-31 led blinky but in rtos
    it's not ideal but hey it works what can you do
2023-11-01 start configure development board's io from its gpio
2023-11-01 init another led on extension board
2023-11-02 start from zero
    [ELEC3300 Debug.cfg]
2023-11-02 Add DMA2D support for faster framebuffer operations & draw point works!!!!
2023-11-07 finish set up ADC for joystick & merge with touch screen
2023-11-07 update ioc for Joystick ADC and Button gpio
2023-11-07 add SWIO, DMA & FATFS config generated by .ioc
2023-11-08 update the adc setting and unfinished cmakelist
2023-11-08 no build error now
    [fatfs.c, fatfs.h]
2023-11-08 fix fatfs testing function
    [fatfs.c, fatfs.h, main.c]
2023-11-09 Add button and joystick support to controller
2023-11-09 Fix SDIO hardware flow control and add LVGL tick hook
    [stm32f4.cfg]
2023-11-09 Add button control
2023-11-17 pcb done
    [ELEC3300_V1.1_L4.kicad_pcb, ELEC3300_V1.1_L4.kicad_sch, bom.csv, designators.csv, positions.csv, screen.DXF, 工作簿1.xlsx]
