Henry-Loi/Embedded-Game-Console/(notices)

Notices in the files:
ELEC3300/Core/Inc/main.h:
Copyright (c) 2023 STMicroelectronics.
All rights reserved.
This software is licensed under terms that can be found in the LICENSE file
_My_RGB/USMART/usmart.c:
Copyright(C) ÕýµãÔ­×Ó 2011-2021
ELEC3300/Core/Src/user/display/strhelper.h:
This program is free software; you can redistribute it and/or modify
it under the terms of the GNU Lesser General Public License as published by
the Free Software Foundation; either version 2 of the License, or
(at your option) any later version.
